BerkeleyLab/Marble-Mini/(threads)

Thread 1 (2018-12-03):

v0.5 schematic review

gkasprow, 2018-12-03:
The v0.5 schematics are here
[AMC_FMC_Carrier-PcbDoc.pdf](https://github.com/gkasprow/Simple_AFC/files/2640740/AMC_FMC_Carrier-PcbDoc.pdf)

ldoolitt, 2018-12-04:
- [ ] Wire main I2C bus (master of U13 TCA9548A) to FPGA user I/O.
- [ ] Move thermometer and power supply I2C to a separate bus, not direclty accessible to FPGA.
- [ ] Wire GPIO0 of XR77129 to FPGA user I/O.
- [ ] Reduce number of non-WR crystals, maybe to zero; The USB crystal may be OK to
  keep, if it stops vibrating when the USB is unplugged.
- [ ] Reference designators should follow IEEE Std 315-1975, in particular:
  Q - transistors
  U - integrated circuits
  Y - crystals
- [ ] Missing self-JTAG. Please wire four user I/O pins to the JTAG lines.

michallgaska, 2018-12-06:
Ok
Next week I will upload schematic with some changes.

ldoolitt, 2019-03-22:
All these points were addressed since the end of January 2019.

Closed 2019-03-22.

Thread 2 (2018-12-04):

White Rabbit oscillators

gkasprow, 2018-12-04:
@michallgaska please follow recent Metlino/Sayma/RFSOC discusions about WR implementation.
We want to use same approach in all our designs. It was  demonstrated that with 2 I2C controlled XO and one clock buffer we can achieve very good phase noise.
[Here ](https://github.com/sinara-hw/sinara/issues/515#issuecomment-416553527)is the discussion and results

ldoolitt, 2018-12-04:
On Tue, Dec 04, 2018 at 10:43:15AM -0800, Greg Kasprowicz wrote:
> We want to use same approach in all our designs. It was  demonstrated that with 2 I2C controlled XO and one clock buffer we cn achieve very good phase noise.
> [Here ](https://github.com/sinara-hw/sinara/issues/515#issuecomment-416553527)is the discussion and results

Has anyone checked the Si549 for Helium sensitvity?
https://hackaday.com/2018/10/31/helium-can-stop-your-iphone-maybe-other-mems-too/
https://www.youtube.com/watch?v=vvzWaVvB908
The problematic SiTime devices are low-frequency low-power devices, which sound more susceptible.
Still, maybe worth checking, especially since helium is not exactly rare in the target environments.

gkasprow, 2018-12-04:
I've read about helium issues with Iphones.
But this affects only MEMS devices.

ldoolitt, 2018-12-04:
On Tue, Dec 04, 2018 at 12:03:12PM -0800, Greg Kasprowicz wrote:
> I've read about helium issues with Iphones.
> But this affects only MEMS devices.

Yes, it's peculiar to MEMS.  Si549 is crystal-based.  Never mind.

ldoolitt, 2019-04-04:
Thanks @gkasprow for bringing this up, and providing the link to WR oscillator work!

I'm going to close this issue, for the following reasons:
1. We have a (presumably) working design based on the previous generation of WR: 25 MHz and 20 MHz VCXOs driven by DACs, and a CDCM61004 multiplying 25 MHz up to 125 MHz MGTREFCLK.
2. The new approaches are still in evaluation, and might end up dropping one device in favor of using internal Xilinx PLLs.
2. It's not clear to me that the new approach is consistent with the trust model assumed on this board.

This topic can be revisited after our first hardware iteration.

Closed 2019-04-04.

Thread 3 (2019-01-10):

Consider table-based entry of pin mapping

ldoolitt, 2019-01-10:

jeinstei, 2019-01-10:
migen/litex style?

ldoolitt, 2019-01-10:
See attached table.tar.gz.

Using a 60-line python program and some _extremely_ simple lists
of application signals, a netlist file (429 entries) is generated.
With some extra work, I assert this netlist can be injected into KiCad.
I'd need to see the KiCad files as you have them now, before I can work
on that step.

The result would IMHO be far more legible and useful going forward than
having page after page of dense signal lists entered into a GUI.
E.g., pins_for_review.png is a screenshot of "paste b*.txt | less -x15"
that captures all of the FPGA user I/O mapping for this board.
Note that the key data file xc7a100tfgg484pkg.txt is directly downloaded
from Xilinx.

[table.tar.gz](https://github.com/gkasprow/Simple_AFC/files/2747238/table.tar.gz)

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

ldoolitt, 2019-01-10:
@jeinstei: I'd take anything based on flat files.  The example I just posted is the simplest I can imagine, but if migen/litex has something similar --- and comprehensible by mortals!  --- I'd take that too.

ldoolitt, 2019-01-10:
@jeinstei: I've messed around with Litex some.  I respect bunnie, and the blog posting that you reference was part of the kick I needed to get started.  My first-hand experience with Litex is what made me add the caveat "comprehensible by mortals".

ldoolitt, 2020-03-05:
I can't see anyone putting in effort to convert this working design to a different design paradigm, so I'll close this issue.
I still think that designs of this scale (and larger) would greatly benefit from using table-based entry of pin mapping. When scripts have access to this information, it's easy and natural to generate cross-reference tables and other derived files like FPGA constraints.

Closed 2020-03-05.

Thread 4 (2019-03-18):

Invalid FMC GA pin connection

kaolpr, 2019-03-18:
According to FMC specification GA[1:0] pins should be connected to either GND or 3V3PAUX and for FMC1 and FMC2 it should be 0b00 and 0b01, respectively.

michallgaska, 2019-03-21:
Fixed!
Thank you.

Closed 2019-03-27.

Thread 5 (2019-03-20):

Add WR-CLK compatibility

kaolpr, 2019-03-20:
At Creotech we're developing a WhiteRabbit CLK module. It is a MCH tongue that allows distribution of WR clock, PPS and timestamp to all AMC modules in a crate without any external cabling (besides fiber to the WR-CLK).

I see that it is possible to make Marble compatible with WR-CLK with relatively low effort:

* TCLKA and TCLKB should be connected to FPGA (SRCC pins),
* at least two MLVDS RX pairs should be connected (ports 17, 18).

Required pins are available in banks 15 and 16.

ldoolitt, 2019-03-21:
> At Creotech we're developing a WhiteRabbit CLK module.
> [It] allows distribution of WR clock [and data].

Sounds great!

> I see that it is possible to make Marble compatible with WR-CLK with relatively low effort:
> Required pins are available in banks 15 and 16.

Maybe.

> * TCLKA and TCLKB should be connected to FPGA (SRCC pins),

TCLKA and TCLKB are diff pairs on AMC backplane.
CC pins in general are a precious commodity in this design.  Let me summarize their allocation per-bank (commit 9dde4030 or c8fd3271):
  b13.  FMC2 LA17 LA18, 2 non-clock; 35-pin bank, half of FMC2, no spare pins
  b14.  FMC1 LA0 LA1 CLK0 CLK1; full
  b15.  MII_RX_CLK, FMC1 LA17 LA18, 1 non-clock; LA33 could be moved
  b16.  VCXO, TMDS, 2 non-clock; 3.3V bank, not valid for LVDS output
  b34.  FMC2 LA0 LA1 CLK0 CLK1; full
  b35.  DDR3 only; full

I can see how to add one LVDS clock to bank 15; there are (more than) two empty pins, and LA33 can be moved.  Will require a remap of at least one MII pin, e.g., MII_RX_DV to H15.

Adding the second LVDS clock is harder; all I can think to do is displace MII_RX_CLK to b16.  That sounds like it will mess up both its timing and voltage threshold compared with all the other MII pins.

When counting b15 pins in the current design, you can consider PHY_RSTn = M17 available after a remap; it's not timing critical.

The other approach is to use pairs on b16, with its 3.3V bank supply.  That prevents use of internal termination, so a 100 Ohm external resistor would be needed per input pair.

> * at least two MLVDS RX pairs should be connected (ports 17, 18).

It sounds like you're asking for two more LVDS input pairs to come from the AMC backplane.  Do these inputs need to be on the same bank as TCLKA and TCLKB?  Are there special considerations for MLVDS on Xilinx 7-series HR pins, distinct from LVDS?  I'm clearly not an xTCA expert; I don't see identifiable "ports 17, 18" on the AMC fingers in our schematic.

Eight total pins are not available on b15 without totally rethinking the MII interface.  If, instead, we consider using b16 and external termination resistors, six pins are immediately available, including two clock pairs.  Freeing up two more pins there will take a little effort, but a couple low-speed signals could be moved to a 2.5V bank.  Worst case, that means adding new level-shift chips.

If the LVDS inputs and the clocks can be on different banks, things might get a bit more flexible.  I have not looked at the layout to see if that adds extra constraints; I know b14 is pretty much surrounded.

ldoolitt, 2019-03-21:
Mikołaj -

Thanks for looking at our board design!

On Wed, Mar 20, 2019 at 04:24:36AM -0700, Mikołaj Sowiński wrote:
> At Creotech we're developing a WhiteRabbit CLK module.
> [It] allows distribution of WR clock [and data].

Sounds great!

> I see that it is possible to make Marble compatible with WR-CLK with relatively low effort:

Maybe.

> * TCLKA and TCLKB should be connected to FPGA (SRCC pins),

TCLKA and TCLKB are diff pairs on AMC backplane.
CC pins in general are a precious commodity in this design.  Let me
summarize their allocation per-bank (commit 9dde4030 or c8fd3271):
  b13.  FMC2 LA17 LA18, 2 non-clock; 35-pin bank, half of FMC2, no spare pins
  b14.  FMC1 LA0 LA1 CLK0 CLK1; full
  b15.  MII_RX_CLK, FMC1 LA17 LA18, 1 non-clock; LA33 could be moved
  b16.  VCXO, TMDS, 2 non-clock; 3.3V bank, not valid for LVDS output
  b34.  FMC2 LA0 LA1 CLK0 CLK1; full
  b35.  DDR3 only; full

I can see how to add one LVDS clock to bank 15; there are (more than)
two empty pins, and LA33 can be moved.  Will require a remap of at least
one MII pin, e.g., MII_RX_DV to H15.

Adding the second LVDS clock is harder; all I can think to do is displace
MII_RX_CLK to b16.  That sounds like it will mess up both its timing and
voltage threshold compared with all the other MII pins.

When counting b15 pins in the current design, you can consider
PHY_RSTn = M17 available after a remap; it's not timing critical.

The other approach is to use pairs on b16, with its 3.3V bank supply.
That prevents use of internal termination, so a 100 Ohm external
resistor would be needed per input pair.

> * at least two MLVDS RX pairs should be connected (ports 17, 18).

It sounds like you're asking for two more LVDS input pairs to come
from the AMC backplane.  Do these inputs need to be on the same bank
as TCLKA and TCLKB?  Are there special considerations for MLVDS on
Xilinx 7-series HR pins, distinct from LVDS?  I'm clearly not an xTCA
expert; I don't see identifiable "ports 17, 18" on the AMC fingers in
our schematic.

Eight total pins are not available on b15 without totally rethinking
the MII interface.  If, instead, we consider using b16 and external
termination resistors, six pins are immediately available, including two
clock pairs.  Freeing up two more pins there will take a little effort,
but a couple low-speed signals could be moved to a 2.5V bank.  Worst
case, that means adding new level-shift chips.

If the LVDS inputs and the clocks can be on different banks, things
might get a bit more flexible.  I have not looked at the layout to see
if that adds extra constraints; I know b14 is pretty much surrounded.

  - Larry

kaolpr, 2019-03-25:
Sorry far such a late answer.

For minimal compatibility with WR-CLK the following is needed:

- TCLKA -> CC diff pair (this line delivers WR clock)
- 2 MLVDS RX diff pairs (one pair for PPS, other for timestamp)

No restrictions on bank placement.

gkasprow, 2019-03-25:
for MLVDS please use dedicated MLVDS transceivers. Standard LVDS would form long stubs. MLVDS transceivers will also enable using 3V3 LVCMOS lines.

ldoolitt, 2019-03-25:
OK, this is starting to sound plausible.  One possible approach:

Move FMC1_LA33 away from a IO_11(SRCC) pair, still within b15.  This will require a cascade of displacements, depends some on routing; one scenario (ignoring routing):
- MII_RX_DV to IO_L14N (pair with MII_RX_CLK)
- FMC1_LA33 to IO_L20,
- Attach TCLKA to IO_11(SRCC).

Add two channels of MLVDS receiver, output to any two convenient FPGA user I/O pins.
- 1 pin free on 2.5V b15, doesn't sound like a good choice
- 6 pins free on 3.3V b16

I need to try a test synthesis to confirm that it's OK to use IO_L14N as data at the same time that IO_L14P is used as a (single-ended) clock.

I'll defer to Michal whether he thinks this can/should be put in for the first article, or if it would add too much time/effort to the schedule.

ldoolitt, 2019-03-25:
@kaolpr:
>  2 MLVDS RX diff pairs (one pair for PPS, other for timestamp)

Couldn't a single lane cover this?  GPS receivers with RS-232 NMEA outputs do this all the time. The start of the timestamp message _is_ the PPS marker.

kaolpr, 2019-03-28:
@ldoolitt Well, it can be done. Let's reduce compatibility requirement to:

- single diff pair for TCLKA,
- single RX MLVDS pair.

gkasprow, 2019-05-02:
@michallgaska I see that you did not add support for WR. This is simple - add MLVDS transceiver and TCLK.

michallgaska, 2019-05-27:
Done.
Can be closed.

ldoolitt, 2019-05-27:
There is no value to controlling U42-2 (#RE), just tie it low.
That way we can all see that FPGA pin C17 (IO_L12N_T1_MRCC_16) is still unused.

Please name the R net (U42-3) to something short and descriptive.
This will turn into the FPGA pin name in the HDL design.

ldoolitt, 2019-05-31:
Confirmed fixed as of commit 0fbafa19

Closed 2019-05-31.

Thread 6 (2019-03-22):

Small schematic problems 2019-03-22

ldoolitt, 2019-03-22:
Found when reviewing commit b527610f

- [x] U34 is incorrectly attached to the FPGA I2C bus; should be APP.

- [x] U39-22 EXP_INT2 is N/C, should go to EXP_INT.

- [x] Add a pushbutton to ARM GPIO (issue first raised in PM 2019-01-31).

- [x] Add two LEDs to I2C port expander (PCA9555) (issue first raised in PM 2019-01-31).

- [x] Improve fusing of FMC 3P3VAUX: possibly use a single fuse for both slots, and definitely provide clear mechanism for software to discover when/if it blows.

michallgaska, 2019-03-27:
Done

Closed 2019-03-27.

Thread 7 (2019-03-22):

Remap refdes to match specs

ldoolitt, 2019-03-22:
The requirements/specs call out specific functionality by refdes:

- U1, the FPGA, Artix-7 in FG484
- U2, a housekeeping microcontroller
- U3, a 512M x 16 DDR3L memory chip
- U4, an RGMII 1000BASE-T PHY
- U5, an RGMII 1000BASE-X PHY
- P1, LPC FMC carrier
- P2, LPC FMC carrier

where we have since merged U4 and U5; the PHY should be called U4.

Please renumber parts in the Kicad design to match.
Calling the primary chip on the board U30 seems suboptimal.
On the layout silkscreen layer, these refdes should be 3 X larger than nominal.

michallgaska, 2019-04-18:
Done

Closed 2019-04-18.

Thread 8 (2019-03-22):

schematics cosmetics

gkasprow, 2019-03-22:
cosmetic issues
- [x]  global FMC labels should be bi-dir not only inputs
- [ ] in all OHWR designs we use certain power port nomenclature like P3V3, N5V0 etc. Is there some reason this was changed? @ldoolitt any preference here
- [x] too many 2k2 I2C pullups. Make sure that when certain port is enabled, the pullup resistance is not lower than 1k. THe switch adds some R to the path and may cause issues. I recommend replacing all pullup R after the switch with 22k
- [x] the Q3 seems to be installed in wrong direction. The inrush current limiter will be bypassed by internal diode.
- [x] please add I2C devices map t othe I2C switch sheet to make sure we don't have address overlaps
- [x] for SFP cages please set right Rd/Td line directions. Now are bidir. RD is output, TD is input.
- [x] add brief name/description of the schematic in the largest frame field.
- [x] for some unknown reason the circuit protecting against glitches on MMC ISP was removed. I suggest adding at least the switch that disables that function when not needed. Otherwize on some PCs the MMC will enter boot mode when USB is plgged and  DTR set to low.

ldoolitt, 2019-03-22:
> in all OHWR designs we use certain power port nomenclature like P3V3, N5V0 etc. Is there some reason this was changed? @ldoolitt any preference here

No preference beyond self-consistency in this design.

> too many 2k2 I2C pullups. Make sure that when certain port is enabled, the pullup resistance is not lower than 1k. The switch adds some R to the path and may cause issues. I recommend replacing all pullup R after the switch with 22k

By "switch" do you mean U5 (TC9548)?  That's a good point; I always looked at that as an active component, but it's actually passive, in a way.  I agree with your 22k solution.  Or maybe 3.3k upstream, 10k downstream?

> please add I2C devices map to the I2C switch sheet to make sure we don't have address overlaps

The I2C subsystem is indeed complicated, and needs better documentation. I was working on that just now.  Address overlaps are not actually a problem, at least after Issue #6 item 1 is fixed.

ldoolitt, 2019-03-23:
> The I2C subsystem is indeed complicated, and needs better documentation.

Here's my first try.  The source eps (xcircuit) file can be supplied on request.
Applies to commit de3cfc8 assuming Issue #6 item 1 is fixed.
Note bus address conflict for U34 and U39, that also needs fixing.
I2C bus signals are named I2C_${BUS}_{SCL,SDA} on the schematic.

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

ldoolitt, 2019-04-04:
@gkasprow please split this list into "bug" (must be fixed before first fab) and "enhancement" (OK to delay work until future revision).  If everything is in the "bug" category, just mark this issue as such.

gkasprow, 2019-04-11:
we can close it now, remaining issues are not relevant anymore.

ldoolitt, 2019-04-15:
Checking commit 38e794c1.  Remaining items in order of importance:

> for SFP cages please set right Rd/Td line directions. Now are bidir. RD is output, TD is input.

SFP1 and SFP2 are fixed, but SFP3 and SFP4 are still wrong.  Please fix.

> add brief name/description of the schematic in the largest frame field.

Not added yet.  Definitely in the "nice to have" category.

> power port nomenclature

Can be left as is for prototyping; we'll see what a larger audience says later.

ldoolitt, 2019-05-02:
Closing this issue.  Thanks @michalgaska for following up on seven of the sub-issues!
If we get complaints about the power supply names, we can update after the first prototypes are made and tested.

Closed 2019-05-02.

Thread 9 (2019-03-26):

Power objects +3V3 and +3V3MP

michallgaska, 2019-03-26:
For some reasons, KiCad can't separate +3V3 and +3V3MP on PCB. It is seen as the same object on PCB. I thought that it was my mistake when I created the power object in the library. But I have tried a few times and I still have the same issue.
Due to this issue, I can't finish two polygons.
I asked Tom Włostowski for a piece of advice in email but I still have been waiting for his answer.

gkasprow, 2019-03-26:
Just change the name of one of them to i.e. P3V3MP Aren't they shorted somewhere on the schematics? Can you look to the netlist if they are not connected somewhere?

gkasprow, 2019-03-26:
@michallgaska U10 and U7 have hidden net which is connected to +3V3MP. It may have already assigned net name to supply pin and this can cause the issue

michallgaska, 2019-03-27:
I found it.
Some devices have a supply pin named VCC and for an unknown reason, KiCad connects these pins to +3V3.
I changed pins name and it solved the issue.

Closed 2019-03-27.

Thread 10 (2019-03-27):

J4 (ethernet connector) alignment pins

yetifrisstlama, 2019-03-27:
The J4 (8P8C, a.k.a. RJ45) footprint has two mechanical alignment pins (NPTH) that erroneously have pad numbers 21 and 22, duplicating the _real_ 21 and 22 pads that are used for the shield.
They also shouldn't have a Net associated to them. This makes up for 2 of the remaining `unrouted connections`.

For some reason the Net and pad number disappears when you check `Show pad in outline mode` in the Pad properties.

Tested on Kicad 5.1.0-62-ge5de787f8 and Kicad 5.1.0-rc1-109-ge71b21596.
Maybe it's really a footprint problem?

michallgaska, 2019-04-02:
Fixed

Closed 2019-04-02.

Thread 13 (2019-04-08):

DC drop simulations

michallgaska, 2019-04-08:
I made a preliminary simulation of voltage drop on power lines.
There are no huge voltage drops so it looks very promising.
Polygons have slightly too big clearance to vias in comparison to the original project.
Results would be a little better if I had Hyperlynx files with proper clearance.

**1V @ 6A:**
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

**1V MGTAVCC @ 0.2A**
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

**1.2V MGTAVTT @ 0.1A**
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

**1.35V @ 0.55A**
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

**1.8V VCCAUX @ 0.4A**
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

**2.5V @ 1.1A**
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

**3.3MP @ 0.15A**
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

**3.3V @ 2.85A**
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

gkasprow, 2019-04-08:
@michalgaska did you update the stackup in Hyperlynx? The tool places default stackup since the Kicad does not have the stackup editor.

michalgaska, 2020-09-12:
Simulations were made with proper stackup.
The issue can be closed.

Closed 2020-09-12.

Thread 14 (2019-04-15):

3P3VAUX monitor

ldoolitt, 2019-04-15:
Please change R259 and R261 to about 1kOhm.
I don't think we want the MMC to be able to (attempt to) power 3P3VAUX from an I/O pin after a fuse is blown.

michallgaska, 2019-04-15:
Done

Thread 15 (2019-04-15):

ERC errors

ldoolitt, 2019-04-15:
As of commit 38e794c1, schematic ERC (Electrical Rules Check?) reports 10 Errors and 423 Warnings.  I'm not qualified to comment on whether any of these represent actual netlist errors that need to be fixed before prototyping.  I do think the design should pass ERC before it can be considered done and releasable.

ldoolitt, 2019-04-26:
As of commit fdb63ea5, schematic ERC reports 11 Errors and 53 Warnings.  Sounds like an improvement to me, thanks @michalgaska!  It would be nice to get the Error count down to zero, if that's possible.

yetifrisstlama, 2019-04-27:
some thoughts on the schematic ERC errors I was seeing:

  * `Label not connected anywhere else in the schematic` I've seen this on many busses. Looks like a Kicad bug / weirdness to me, as the highlight net tool shows the connection is there
  * `Pin connected to other pins, but not driven by any pin`  ... needs a PWR_FLAG symbol placed on the net to tell Kicad it is driven by a power source
  * `Pin not connected (use a "no connection" flag to suppress this error)` ... self explaining
  * `More than one name given to this bus or net` ... i suspect this is due to a hidden pin of the same name. Not sure how to solve this

ldoolitt, 2020-05-05:
Fixed (to the maximum extent possible) in commit 6cafe828 (branch fab2).
Still one unavoidable ERC error due to the ERC process not understanding DNF attribute of Y1.

Closed 2020-05-05.

Thread 16 (2019-04-15):

Paste on gold fingers

ldoolitt, 2019-04-15:
As of commit 6ad5d6c2, there is both front and back paste placed on the gold fingers of P1 (AMC).  Layer IDs are F.Paste and B.Paste.  This needs to be taken off.  Probably a footprint problem.

gkasprow, 2019-04-16:
the same probably applies to fiducials and test points.

michallgaska, 2019-04-18:
Done

Closed 2019-04-18.

Thread 17 (2019-04-15):

Too much silkscreen clutter by gold fingers

ldoolitt, 2019-04-15:
As of commit 6ad5d6c2,
Cute rendition of the EMI fingers of the SFP cage will clutter the area also used by P1 (AMC) gold fingers.  It would be better to take away that ink from F.SilkS.

michallgaska, 2019-04-18:
Done

Closed 2019-04-18.

Thread 18 (2019-04-15):

Integrate KiCad workflow better with git

ldoolitt, 2019-04-15:
At the minimum, I think the following files should be removed and listed in .gitignore:
* AMC_FMC_Carrier-PcbDoc.kicad_pcb-bak
* fp-info-cache
* AMC_FMC_Carrier-PcbDoc-rescue.lib

but please check this with git and/or KiCad experts, and test that the resulting repo is usable.

There's a longer set of instructions for using git and KiCad together at [plotkicadsch](https://jnavila.github.io/plotkicadsch/).  There are clearly some good lessons in there, but in total it's kind of intricate. We don't have to do everything all at once.

ldoolitt, 2019-05-16:
@michalgaska and I have both made commits addressing this issue.

Other people should check that the result is usable, and maybe leave a comment here.

yetifrisstlama, 2019-06-03:
Looks good to me, can be closed.

ldoolitt, 2019-06-04:
Closing now.  Please re-open if you (anyone) find specific problems.

Closed 2019-06-04.

Thread 19 (2019-04-16):

Logos

ldoolitt, 2019-04-16:
Add as many as you can think of: Creotech, Politechnika Warszawska, LBNL, KiCad, OHWR.
Also designers' names: Michal, Larry, and as many others as want to be associated with the result.
If you can find room, getting something in copper (not just silkscreen) is a "nice to have".
Directly before release, add a revsion date and git commit id.

ldoolitt, 2019-04-29:
The logos are on and look great!  Thanks @michalgaska!
Leaving this issue open as a reminder to
> Directly before release, add a revision date and git commit id.

csp, 2019-04-29:
I see that the front has two areas with logos, one of which will be covered when a mezzanine is connected. For the others, can we replace those with at least LBNL and Creotech logos?

gkasprow, 2019-05-02:
I'm not sure if we can place CE logo here. We did not certify this board.
The board is just a component so we would rather certify the whole box with this board and place the CE logo there.

gkasprow, 2019-05-02:
We usually do not place individuals names on the boards. It's a collective effort so just institution name is sufficient. Names are placed on schematics and PCB drawing tables where indicate who designed and who verified each part.

ldoolitt, 2019-05-02:
I agree a board like this is a big team effort - and putting more names on is fine.
But if you're uncomfortable with people's names on the board, take them off.
We at LBNL typically do put the designers' names on.  I think of it like an artist signing a painting, giving credit and recognition to someone who put in the effort.

gkasprow, 2019-05-02:
well, it's not really a piece of art :) It's good engineering. I had a colleague who treated PCBs like a piece of art but they usually did not work well because for him good look was more important than Signal Integrity :)
On commercially available electronics you won't find authors names.
A long time ago we had such discussion at OHWR and the conclusion was that we do not place a list of all contributors, but a link to the repo where this information is provided.

ldoolitt, 2019-05-02:
> On commercially available electronics you won't find authors names.

One exception is on chip masks, where you find all kinds of crazy stuff.  :-)
I can accept the conclusion, no names on this board.

ldoolitt, 2019-05-10:
Closing because it's mostly done, and the un-done stuff is not related to the issue title.
Will open a fresh issue for revision date and git id.

csp, 2019-05-30:
Re-opening this issue. This is my original request regarding logos: I see that the front has two areas with logos, one of which will be covered when a mezzanine is connected. For the others, can we replace those with at least LBNL and Creotech logos?

ldoolitt, 2019-06-03:
Confirmed good in commit 0293096. Thanks @michalgaska!

Closed 2019-06-03.

Thread 20 (2019-04-22):

Please provide FPGA pin mapping file

ldoolitt, 2019-04-22:
Either simple flat-text, or .xdc for Vivado.
Ideally this will machine-generated from the KiCad schematic, with instructions for doing so in the README (hope for "make marble.xdc").
If some post-processing is needed to get this into a useful form, we at LBNL can help.
It's definitely not acceptable to key it all in by hand, A really ugly but possible short-term workaround is to cut-and-paste things bank-by-bank from the PDF.

gkasprow, 2019-04-23:
I used to extract such info from raw netlist. It's just a metter of copying
piece of netlist that contains nets around FPGA designator. One remark -
make sure all FPGA nets are named. Sheet entries do not alway name nets so
I always add net names close to the FPGA pins

ldoolitt, 2019-04-23:
@gkasprow wrote: I used to extract such info from raw netlist.

Sure, there's always a way.  The more automated and guaranteed-correct the better.
The path would be more clear if anyone had followed through on #3.

gkasprow, 2019-05-02:
Orcad PCB netlist output seems to be human-readable form. It's the only format among supported by Kicad where nets are grouped by symbols.
The netlist looks almost ready to use :
```

(  AA3 FMC2_LA_9_N )
  (  AA4 FMC2_LA_1_N )
  (  AA5 FMC2_LA_15_P )
  (  AA6 FMC2_LA_11_N )
  (  AA7 +2V5 )
  (  AA8 ? )
  (  AA9 FMC2_LA_27_P )
  ( AA10 FMC2_LA_20_P )
  ( AA11 FMC2_LA_20_N )
  ( AA12 GND )
  ( AA13 FMC2_LA_31_P )
  ( AA14 FMC2_LA_21_N )
  ( AA15 FMC2_LA_32_P )
  ( AA16 FMC2_LA_26_N )
  ( AA17 +2V5 )
  ( AA18 FMC1_LA_6_P )
  ( AA19 FMC1_LA_10_P )
  ( AA20 FMC1_LA_7_P )
  ( AA21 FMC1_LA_7_N )
```

after one minute of play with text file I got ready to use pin mapping
[FPGA_pin_mapping.txt](https://github.com/gkasprow/Simple_AFC/files/3137409/FPGA_pin_mapping.txt)

ldoolitt, 2019-05-10:
This is helpful, and I'll add a separate issue for myself to synthesize a test bitfile.
I will leave this issue open until there's a fully automatic flow from KiCad to Xilinx .xcd file.

ldoolitt, 2020-03-05:
This work was completed August 2019 with commit a1ed1ff.
Instructions for how to generate Marble.xdc are in the README.
Tested on hardware, works.
Thanks, @michalgaska!

Closed 2020-03-05.

Thread 21 (2019-04-25):

Improve support for FMC JTAG

ldoolitt, 2019-04-25:
If I read the schematics correctly, the only access provided to the FMC JTAG pins is via J14 Conn_ARM_JTAG_SWD_10.  The JTAG chain (slaves) accessible from that connector starts with U2 LPC1776, and will have FMC1 and FMC2 switched in when the corresponding PRSNT_M2C signals are asserted.

My understanding is that a few FMC mezzanine cards (including CUTE-WR) use their JTAG lines for maintenance. While these boards could be tested with the current design of Marble, by attaching a JTAG pod to J14, there's no sane way to support deployment of such cards.

Please add the capability to drive these FMC JTAG pins by GPIO pins of U2 LP1776 (MMC), which can bit-bang the JTAG protocol.  The MMC is presumed to be attached (or attachable, however indirectly) to some source of programming instructions for the FMC mezzanines. You can keep J14's capability to master FMC JTAG as a resistor-strappable option.

This concern was prompted by studying ERC output, in combination with emails from last July.
The current design leaves FMC TRST pins floating; shouldn't they be tied down somehow?

michallgaska, 2019-04-26:
I connected both FMC JTAG to MMC.
Driving FMC JTAG by MMC should be a default mounting option?

gkasprow, 2019-04-26:
I'm not sure if I follow you. The idea behind FMC JTAG was identical as we do in Sayma AMC. Some FMC modules, like CUTE-WR nodes, have FPGA on FMC. The FPGA JTAG is accessible via FMC JTAG.
So, once the FMC is inserted, the FMC is included in the carrier JTAG chain.
There is a risk that FMC is not designed according to specification and the chain is not closed by default (TDO not shorted with TDI). In such a case the MMC should be able to overwrite the PRSNT pin and close the FMC JTAG chain by the analog switch.
Xilinx devkits have JTAG implemented in the same manner.
MMC can use bit-bang JTAG, there is even Xilinx virtual cable protocol, but it makes sense when MMC has Ethernet access. I don't see many use cases for MMC- FMC JTAG connectivity.

ldoolitt, 2019-04-26:
> I'm not sure if I follow you.

I agree this is confusing, and that's bad.  For a start, I request more notes on the schematic about which zero-ohm resistors are placed to enable which features.

> The idea behind FMC JTAG was identical as we do in Sayma AMC.

OK.  I haven't looked at Sayma design in months, I guess i should refresh myself.
Can a remote in-the-field Sayma carrier, not attached to a bench-top JTAG pod, act as a JTAG bus master for the FMC JTAG chain?

> Some FMC modules, like CUTE-WR nodes, have FPGA on FMC.

Yes.  Clarifying, some FMC mezzanine cards with an on-board FPGA attach that chip's dedicated JTAG slave port to the FMC connector's dedicated JTAG pins.

> There is a risk that FMC is not designed according to specification and the chain is not closed by default (TDO not shorted with TDI). In such a case the MMC should be able to overwrite the PRSNT pin and close the FMC JTAG chain by the analog switch.

Right, that's a useful feature.  I guess it is part of the Sayma design.  Is it part of our Marble design now?

> Xilinx devkits have JTAG implemented in the same manner.

Can you be a bit more specific?  Which devkit? Are you talking about the analog switch with an override feature? And is this the JTAG chain that is only accessible to a bench-top JTAG pod?

> MMC can use bit-bang JTAG, there is even Xilinx virtual cable protocol, but it makes sense when MMC has Ethernet access.

The MMC is always assumed to have a data link to the outside world.  In xTCA that's over IPMB.  In the NAD world I will set up a bridge from Ethernet through the FPGA via SPI.

> I don't see many use cases for MMC- FMC JTAG connectivity.

OK.  But I don't want to force people to add extra hardware in order to access the FMC JTAG chain.  That hardware may be easy and convenient in a lab setting, and that use case should be supported, but Marble is intended to support deployment of tens or hundreds of units out in the field where physical access is a problem.

> Driving FMC JTAG by MMC should be a default mounting option?

Since we don't have software written, and it's a specialized use case (no immediate demand to deploy Marble+CUTE-WR in the field), I vote to have the standard/initial build jumpered to give J14 access to FMC JTAG.

gkasprow, 2019-05-02:
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

In Sayma we do not have such a feature because there are other components in the ARTIQ environment that are updated via USB JTAG.

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

not yet. One resistor and connection to the MMC does the job.

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

for example KC705. In our case, it is implemented in the same way.
Moreover, I would add 0R resistors that disable MMC JTAG.
MMC should have its individual SWD connector mounted by default. Using the same JTAG connector for both FPGA and MMC would be a real nightmare during development. I'm afraid that CPU debugger may have issues with talking with CPU with other JTAG devices in the chain. Another problem would be with SWD mode that won't work in such setup.
So I think dedicated SWD/JTAG connector is a must. Just copy working solution from Sayma and do not mount 0R resistors that connect it with rest of JTAG chain.

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

OK, this would work but I doubt if somebody finally implements it, having working self-programming solution :) Or are you talking about a link for diagnostics, sensor readout etc ?

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

OK, It's better to add such support then.

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

agree

michalgaska, 2020-09-15:
Can be closed

Closed 2020-09-15.

Thread 22 (2019-04-27):

U35 (XRP7724) pin 23 and 34 are not connected

yetifrisstlama, 2019-04-27:
quote from the datasheet:

Gate Drive supply. Two independent gate drive supply pins where pin 34 supplies drivers 1 and 2 and pin 23 supplies drivers 3 & 5. One of the two pins must be connected to the LDO5 pin to enable two power rails initially. It is recommended that the other VCCD pin be connected to the output of a 5V switching rail(for improved efficiency or for driving larger external FETs), if available, otherwise this pin may also be connected to the LDO5 pin. A bypass capacitor (>1uF) to PAD is recommended for each VCCD pin with the pin(s) connected to LDO5 with shortest possible length of etch.

michallgaska, 2019-04-29:
Done

Thread 23 (2019-04-27):

U36, U37 (NCP186AMX180TAG): IN and OUTPUT pins are swapped

yetifrisstlama, 2019-04-27:
Pin numbers on the schematic symbol do not match the datasheet (XDFN8 package)

https://www.mouser.com/datasheet/2/308/NCP186-D-968152.pdf

Needs to be fixed on the PCB as well

michallgaska, 2019-04-29:
Great point!
Fixed

Closed 2019-04-29.

Thread 24 (2019-04-27):

U27 (MAX6639) pin 12 (DXP2) not connected

yetifrisstlama, 2019-04-27:
from datasheet:
Do not leave unconnected; connect to DXN if no remote diode is used

https://datasheets.maximintegrated.com/en/ds/MAX6639-MAX6639F.pdf

michallgaska, 2019-04-29:
Fixed

Closed 2019-04-29.

Thread 25 (2019-04-27):

FMC_2.sch: pin c34 is hard-wired to FMC2_3P3VAUX

yetifrisstlama, 2019-04-27:
It should be connected to net GA0_2 instead. The connection to FMC2_3P3VAUX is made on the top level.

michallgaska, 2019-04-29:
fixed

Closed 2019-04-29.

Thread 26 (2019-04-29):

SW2 placement

ldoolitt, 2019-04-29:
SW2 looks ideally placed for AMC slot builds, but that's not very useful for NAD builds.
Please add a header in parallel, so a cable can be used to move this functionality to a chassis panel.  NAD builds would mark SW2 as DNP.

My ideal would be a 4x2 100-mil header with connections to two push-buttons (PB1 and SW2) and two LEDs (maybe with separate ballast resistors but otherwise parallel with LD11 and LD13?).  For height reasons this would have to be placed "to the right of" the FMC connector. Compatible switch/LED assemblies are cheap and widely available as part of ATX PC cases or case-substitutes.

gkasprow, 2019-05-02:
The idea behind SW2 was board reinitialization in the crate without a need for power cycling.
The use case for a stand-alone application would probably be different because power cycling is much easier than in MTCA.

ldoolitt, 2019-05-02:
Of course everything is software-defined, but my biggest interest in SW2 for a NAD is a "reset IP address to factory default" function.

gkasprow, 2019-05-02:
Good idea. We can also place tiny SMT switch available via panel hole with some needle.

ldoolitt, 2019-05-02:
> We can also place tiny SMT switch available via panel hole with some needle.

Fine with me, if you can make it work.  The panel side for a NAD is squeezed in by the Ethernet and SFP, and power entry, where there isn't a lot of room left.

gkasprow, 2019-05-02:
I use tiny switch that fits below Ethernet connector.
KSS241G LFS

On Thu, 2 May 2019 at 17:24, Larry Doolittle <notifications@github.com>
wrote:

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

michallgaska, 2019-05-09:
I added a tiny switch.
@ldoolitt do you still need a header with connections to two LEDs?

ldoolitt, 2019-05-09:
> I added a tiny switch.

I see it, SW3.  It looks too close to the board edge.  Its drawing shows the button extending 0.8 mm from the pad; the layout in commit 7c5c3c37 only leaves 0.5 mm.

> do you still need a header with connections to two LEDs?

No, this is fine for now.

ldoolitt, 2019-05-10:
Re-opened as a reminder to shift the new SW3 (in parallel with SW2) left by at least 0.5 mm.

michallgaska, 2019-05-13:
Done

Closed 2019-05-13.

Thread 27 (2019-04-29):

Review and organize DNP status for parts

ldoolitt, 2019-04-29:
We keep talking about parts being loaded for only one of the two styles of board assembly, AMC and NAD.  Since the first prototypes are headed for NAD-style testing at LBNL, AMC-only parts should be marked DNP (do not populate) for now.

We do need some organization and/or KiCad mechanism to clearly document what parts go with which build, such that a BOM and assembly file can be constructed cleanly for both types.  That step is _not_ a prerequisite for the first prototype (NAD) assembly.

gkasprow, 2019-05-02:
For the CERN project the Altium variants are not used for a number of reasons.
Each component has a field called "Assembled" and value "Yes" or "No". And this field is then generated with BOM, but NOT with p&p files!
This cames probably from an early version of Altium where assembly variants were not supported.
I remember the times where PCAD was used at CERN, then Altium purchased PCAD and discontinued it. All clients switched to Altium then. Maybe it is reminiscent of those times.
Good assembly variant support like Altium has would be a great tool.
I tried to use Mentor Xpedition assembly variants but it was a real nightmare. The Altium approach where assembly variant information is preserved in a dedicated file is a good idea because it does not affect schematics nor PCB, only BOM and p&p files.

michallgaska, 2019-05-09:
I found a very nice tool to generate a BOM file. It supports PCB variants.
https://github.com/SchrodingersGat/KiBoM

ldoolitt, 2019-05-09:
> I found a very nice tool to generate a BOM file. It supports PCB variants. https://github.com/SchrodingersGat/KiBoM

Yes, that looks like it has the features we want.

Do you plan to set up for this (adding all the Config (fit_field) entries) before the prototype fab run?

michallgaska, 2019-05-10:
I made the first attempt to set up a variant for the standalone version using KiBoM.
I have created _standalone_ variant of the board.
which clock is the default FPGA MGT clock? WR?

ldoolitt, 2019-05-28:
First prototype build will be standalone (NAD) style, using the WR clock.
Referencing commit d4c25c16, I think dnf attributes should be added to:
- [ ] S1
- [ ] SW2
- [ ] 16 capacitors routing MGT lanes to AMC fingers
- [ ] 4 capacitors routing MGT_CLK_1 to other than FPGA_REF_CLK0
- [ ] 2 capacitors routing MGT_CLK_0 to other than ??
I don't see a particularly useful source for MGT_CLK_0.  It might be nice to have an option for FMC2_CLK0_M2C, but that would conflict with the existing route of that clock to bank 34 MRCC pins.

That's all I see for now, but I'll keep looking.
@gkasprow  should also review this list.

Some of these, like the MGT lane routing, look already handled by the "config" attribute on the parts, which will drive KiBoM.  Other than clicking on the attribute editor for every part, do you know of a way to review all the "config" attribute values?

It would also be nice if there were documenation (in README.md?) for what the board's KiBoM options are, and how to generate the BoM file with that tool.  Maybe it's there, and I just don't see it.

ldoolitt, 2020-03-05:
The design as-built uses KiBoM as suggested, so I'll close this issue.

There is a minor residual problem that the build variant and resulting parts (or DNF) selection is not visible on schematics.  This is a generalization of #47, so that's where further discussion belongs.

Closed 2020-03-05.

Thread 28 (2019-05-03):

DDR3 schematic tweaks

ldoolitt, 2019-05-03:
A friend of mine looked through the schematic and gave me comments.
I hope this issue captures those ideas relating to the DDR3 schematic.

In general, deviations in this part of the schematic from Arty should be looked on with suspicion.
If we have a good reason to deviate, that should be noted and explained on the schematic.
I'm taking as reference Arty rev E.1, 2018-01-09
https://reference.digilentinc.com/_media/reference/programmable-logic/arty-a7/arty_a7_sch.pdf
7ab6ec142107efa10dd91654ad1f462544ba190af551292ac7d49c4649af9870  arty_a7_sch.pdf

Particulars:
- [ ] Change clock termination to 80 Ohms differential
- [ ] Change address termination resistors to 40 Ohms
(see https://www.xilinx.com/support/answers/42024.html, which talks about using 40 Ohms for the trace impedance, also)
- [ ] ODT pin termination should be 40 Ohms to V_tt
- [ ] Add more decoupling capacitors on +1V35, currently 8 where Arty has 19

gkasprow, 2019-05-03:
fully agree.
- [ ] there should be more capacitors on VTT. At least 5.
- [ ] 40Ohms are hard to get. use 39R9 instead.
- [ ] make sure that address lines impedance is 40Ohms.
- [ ] the clock signal is still referenced to VTT so I wouldn't use single 80R differential termination but 2x40R as it is now.

ldoolitt, 2019-05-03:
> 40Ohms are hard to get. use 39R9 instead.

OK, that's definitely close enough to 40. Arty uses 40R2, I rounded.

> the clock signal is still referenced to VTT so I wouldn't use single 80R differential termination

I see several clock signal termination topologies suggested by experts.  DIMMs use split termination resistors, center tap AC coupled to V_DD.  Weird.
https://www.micron.com/-/media/client/global/documents/products/data%20sheet/modules/sodimm/jsf4c128x64hz.pdf
Of course, many experts also say to make sure to run signal integrity simulations as the final guide.

ldoolitt, 2019-05-03:
>>  40Ohms are hard to get. use 39R9 instead.

> OK, that's definitely close enough to 40. Arty uses 40R2, I rounded.

Searching Digi-Key for 1% 0402 resistors near 40 Ohms, the top 10 in quantity-available are all either 39R0, 39R2, or 40R2. I recommend putting 40R2 on our schematic.  There are just over 2 million Yageo RC0402FR-0740R2L on-the-shelf.

ldoolitt, 2019-05-09:
> [WP484 v1.0] uggests using 50R impedance and termination.

That document dates from September 2016.  AR# 42024 I gave above with the 40R suggestion is dated June 2014.  The Arty schematic that uses 40R2 is dated January 2018.

> we applied such DDR design in Kasli and it works perfectly.

At what speed?  The Arty also works perfectly.  A single resistor is easy to change, but a generic change from 50R to 40R means changing 25 such resistors, which would be tedious.

michallgaska, 2019-05-15:
I added more decoupling capacitors to the DDR3 power supply and VTT.
I changed the termination resistors to 40R2.
I didn't change traces impedance.
According to the simulations, DDR3 will work.

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

Closed 2019-05-15.

Thread 29 (2019-05-03):

[CRITICAL] Exar current sense connection

gkasprow, 2019-05-03:
Existing connection of current sense of Exar will cause immediate damage to the controller.
I placed R190, R191, R192, R194 on purpose to make sure GL_RTNx pins won't be connected to the nearest GND potential.
These resistors must be placed very close to the output transistors sources to measure real drop on RDSon. The existing connection will cause the wrong measurement of the MOSFET current and failure of the controller regulation loop. The MOSFET source pad must be connected to the GND by vias and not share the plane with any other component, only the 0R resistor.
Please look at how it was done on Sayma. Highlighted is GND sense connection. Please refer to Exar layout manual.
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

michallgaska, 2019-05-06:
Fixed

Closed 2019-05-06.

Thread 30 (2019-05-03):

power sequencing

gkasprow, 2019-05-03:
The MGTAVTT is derived from +3V3 and VCCAUX is derived from +2V5.
Does it take into account FPGA power sequencing recommendations?
Is a recommended sequence possible with such wiring?

michallgaska, 2019-05-06:
According to the datasheet:
https://www.xilinx.com/support/documentation/data_sheets/ds181_Artix_7_Data_Sheet.pdf

>  The recommended power-on sequence is VCCINT, VCCBRAM, VCCAUX, and VCCO to achieve minimum current draw and ensure that the I/Os are 3-stated at power-on.

> If VCCAUX and VCCO have the same recommended voltage levels then both can be powered by the same supply and ramped simultaneously.

Now the power sequence is:
1. 1V0 (VCCINT, VCCBRAM, MGTAVCC)
2. 2V5 (VCCO) -> 1V8 (VCCAUX)
3. 3V3 (VCCO) -> 1V2 (MGTAVTT)
4. 1.35 (VCCO)

> The recommended power-on sequence to achieve minimum current draw for the GTP transceivers is VCCINT, VMGTAVCC, VMGTAVTT or VMGTAVCC, VCCINT, VMGTAVTT.

Thus MGTAVTT is on after VCCINT and MGTAVCC.
There is no information that MGTAVTT can't be ramped with VCCO.
On Kasli board there is Artix 7 and MGTAVTT is derived from VCCO (2V5) and it doesn't cause any issue.

Closed 2019-05-09.

Thread 31 (2019-05-03):

SI issues

gkasprow, 2019-05-03:
the AMC connector signals have missing reference plane under some trace sectors
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

Moreover, the opposite AMC connectors contacts don't have any GND reference below.
The pad width is 0.47mm so to maintain 50R impedance, the reference should be placed 0.25..0.3mm below. Now there is no reference at all. Look how it is done on Sayma. On second layer there are cutouts in the plane. On L3 there is no copper
P2:
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
L3:
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

gkasprow, 2019-05-03:
The same applies to SFP pads. Look how it is done on Sayma
P2:
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

On L3 there cannot be any traces nor polygons below. To make sure I place there polygon cutout.
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

michallgaska, 2019-05-06:
Fixed

Closed 2019-05-06.

Thread 33 (2019-05-10):

Test synthesis

ldoolitt, 2019-05-10:
Given the pin mapping file posted in #20 , take an exsiting useful design and synthesize for this board. Must happen before board goes out for fab, to make sure we haven't misunderstood some stupid Xilinx physical constraint.

ldoolitt, 2019-05-31:
Vamsi confirms RGMII and DDR3 are ok for synthesis.
FMC looks good, but not fully confirmed.  Still working on it.

ldoolitt, 2019-05-31:
@michalgaska please check DDR3 pin-compatibility with Xilinx MIG.

ldoolitt, 2020-03-05:
Ethernet, MMC, I2C, and Pmod connectivity all work as expected on hardware. FMC connectivity passes tests using the OHWR [FMC Carrier Tester board](https://ohwr.org/project/fmc-conn-tester/wikis/home).  I think the only thing left to do before closing this bug is DDR3 checkout / confirmation. @michalgaska, any progress on Xilinx MIG?

michalgaska, 2020-03-06:
Unfortunately, I don't have any progress with MIG.

ldoolitt, 2020-09-12:
Closing, since the first-prototype run (commit a1ed1ff17) has proven itself with usable with designs from:

* [Bedrock](https://github.com/BerkeleyLab/Bedrock) (no DDR3 support)
* [LiteDRAM](https://github.com/enjoy-digital/litedram) (using all 1024 GiB DDR3)
* conventional Xilinx uBlaze/MIG (but only with 512 GiB DDR3 visible)

Closed 2020-09-12.

Thread 34 (2019-05-10):

Include revision date and git commit ID on board

ldoolitt, 2019-05-10:
Place-holder issue to remind @michallgaska to put board design revision info (including git commit id) on something (silk, copper) physically visible on the hardware.  Necessarily done at the last minute, after all other changes.

Ideally this step will be automated, but that's definitely not essential for the first prototype.

csp, 2019-05-30:
Can we include a version number corresponding to a tag? The first revision should have v1.0 printed on the board, this makes it easy to identify them when we go into production of the next versions and end up with boards of different production runs

michalgaska, 2019-11-13:
I think it is done.

jersey99, 2020-02-04:
Closing this.

Closed 2020-02-04.

Thread 35 (2019-05-13):

FPGA boot and MMC

ldoolitt, 2019-05-13:
Quoting the Marble board's spec:
> As important as the microcontroller is to the long-term serviceability of
> the board, it should not be needed to exercise the core functions of powering
> the board, or loading and running a bitfile.

Side note to @csp: can we convert the spec to Markdown and check it in to github?

The default (reset) state of most LPC1776 I/O pins is as inputs, with a weak (less than 70 microamp) pull-up.

My review of the design, while reading UG470 (7 Series FPGAs Configuration) shows that some changes are needed before this requirement is satisfied. In particular the board should boot from on-board SPI flash (Master SPI Configuration Mode, M[2:0] = 001), without help from the MMC.
- [x] Pull-up ≤ 1 kOhm on M[0] to +2V5
- [x] Pull-down ≤ 1 kOhm on M[1] and M[2]
- [x] Pull-up ≤ 4.7 kOhm on INIT_B (not pull-down)

Right now M[2:0] are attached to the MMC.  I don't have a use case for this. The only thing I could possibly think the MMC would want to do is disable SPI boot, by pulling M[2] high.
Fortunately the LPC I/O are pretty strong, since the required default pull-down is less than 1 kOhm.  Unfortunately the LPC I/O voltage is +3.3V, which doesn't match the +2.5V of these pins. Maybe M[2] gets 330 Ohm series to the LPC1776, with a 1.0 kOhm pull-down?

The pull-up on PROGRAM_B, R160 is currently set to 1 kOhm. The Xilinx requirement is ≤ 4.7 kOhm.  All the examples in UG470 show 4.7 kOhm.
- [x] Use larger value for R160, maybe 2.2 kOhm?

UG470 documentation for the DONE pin says:
"Note: DONE has an internal pull-up resistor of approximately 10 kΩ. There is no setup/hold requirement for the DONE register. These changes, along with the DonePipe register software default, eliminate the need for the DriveDONE driver-option. External 330Ω resistor
circuits are not required but can be used as they have been in previous generations."
- [x] Suggest marking R162 as DNF

ldoolitt, 2019-05-16:
Confirmed all fixed as of commit ceb0f520.  Thanks, @michalgaska !

Closed 2019-05-16.

Thread 36 (2019-05-16):

Fix level of 25 MHz clock supplied to U2 (PHY) and U4 (MMC)

ldoolitt, 2019-05-16:
CLK_25MHZ from CDCM61004R is 3.3V LVCMOS. This is too large a swing for both the MMC XTAL1 pin U2-L2. and the PHY XTAL_IN pin U4-34

- [x] Convert C92 to 150 pF in this configuration
- [x] Remove R132
- [x] Replace R63 with capacitive divider (100 pF / 100 pF) between CLK_25MHZ and U4-34,
suggest placement close to U4

3.3V * 100 / (100+150) = 1.32 V, between 0.28 V and 1.4 V, OK for U2-L2

3.3V * 100 / (100+100) = 1.65 V, less than 1.8 V, OK for U4-34

This assumes there's nothing surprising contained in Marvell's non-public MV-S301630-00, "Oscillator level shifting".

ldoolitt, 2019-05-20:
Fixed with commit 23189cfb.  Looks good, thanks @michalgaska!

Closed 2019-05-20.

Thread 37 (2019-05-29):

Symbol library management

yetifrisstlama, 2019-05-29:
Larry found some issues related to ERC in some of the schematic symbols. However as long as we load the symbols from the `-cache.lib` file, we cannot edit them.

I suggest to rename `AMC_FMC_Carrier-PcbDoc-cache.lib` to `AMC_FMC_Carrier-PcbDoc.lib` and include it in Kicad as a project specific symbol library.

I found [this guide](https://hackaday.com/2017/05/18/kicad-best-practises-library-management/) explaining the details.

Ideally we should not have to depend on `-cache.lib` or `-rescue.lib`

ldoolitt, 2019-06-13:
This specific problem is the tip of a larger iceberg.  We really need the library entries for the specific parts this design uses, in order to maintain or upgrade this design going forward.  This includes getting access to the 3D model part of these items, so as to be able to produce a 3D rendering of the assembled board as shown on this project's README.  This also practically prevents us from pushing changes to github, since every time we load the design, Kicad redirects library links to the local cache.

As I understand it, most or all of these parts come from a CERN library, and there are negotiations taking place for how and when to copy. license, and publish this subset.

This bug sounds trivial, and definitely shouldn't slow down our production of prototypes, but is a critical bug moving forward!  Until it is solved, the OHWR nature of this design is hollow.

ldoolitt, 2020-02-02:
Some WIP on this issue is now in the local-lib branch.
Tomasz is also looking into it.

ldoolitt, 2020-05-05:
More progress in the fab2 branch, based on great work by @yetifrisstlama .
Specifically as of commit 6cafe828 the ERC fixes are in the self-contained libraries.
3D models are **not** currently available.
I'd like to verify that features can be added in this mode before closing this issue.

ldoolitt, 2020-05-27:
Still missing the 3D models, but the fab2 branch feels maintainable, with coordinated commits from three people.  Closing this issue.

Closed 2020-05-27.

Thread 38 (2019-05-31):

acid pockets

gkasprow, 2019-05-31:
make sure that vias are either open on both sides or tented on both sides.
You cannot make via tented on one side because it creates a pocket.

michalgaska, 2019-06-03:
I can't change vias tenting in KiCad.
We have to live with tented vias.

gkasprow, 2019-06-03:
Maybe it's good time to request such feature ?

yetifrisstlama, 2019-06-04:
There is a `Do not tent vias` option when you generate the gerbers (File --> Plot...)

michalgaska, 2019-06-04:
I know that option but we don't want to tent all vias.

gkasprow, 2019-06-04:
just place a polygon on the solder mask which will expose the vias.

michalgaska, 2019-11-13:
Improvement for the next version.

michalgaska, 2020-09-12:
The issue can be closed.

Closed 2020-09-12.

Thread 39 (2019-05-31):

Rename MII signal names to RGMII on the schematic

jersey99, 2019-05-31:
Match signal names to the elusive RGMII standard. Is this the official [standard](https://web.archive.org/web/20160303171328/http://www.hp.com/rnd/pdfs/RGMIIv2_0_final_hp.pdf)??

michalgaska, 2019-06-03:
Done

ldoolitt, 2019-06-03:
I see two symbols and three pages of schematics updated with commit 0293096. But the formal symbol for ETH_PHY is not updated.

ldoolitt, 2019-06-13:
Confirmed fixed in commit 1b3995c.

Closed 2019-06-13.

Thread 41 (2019-05-31):

add u.fl

gkasprow, 2019-05-31:
add u.fl connectors  to the MGT clock

ldoolitt, 2019-05-31:
Specifically a pair of U.Fl as an option for MGT_CLK_0.

michalgaska, 2019-06-03:
Can it be MGT_CLK_1?
It is much easier to route.

ldoolitt, 2019-06-03:
Michal -

On Mon, Jun 03, 2019 at 05:07:08AM -0700, michalgaska wrote:
> Can it be MGT_CLK_1?

Yes, as long as MGT_CLK_0 can still come from the WR clock.

> It is much easier to route.

OK.  I only chose MGT_CLK_0 because MGT_CLK_1 already had three options.
Three and three seemed more likely to allow short stubs compared to
four and two.

  - Larry

ldoolitt, 2019-06-03:
I see this implemented in commit 02930969. Thanks @michalgaska!

Closed 2019-06-03.

Thread 43 (2019-06-14):

DRC fail: Unconnected trace DDR3_ODT

yetifrisstlama, 2019-06-14:
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

michalgaska, 2019-06-17:
Thank you!
I have already fixed it.

Closed 2019-10-10.

Thread 45 (2019-10-09):

Marble-Mini release schematic

jersey99, 2019-10-09:
@ldoolitt @michallgaska Can one of you generate the latest schematic (in .pdf) and create a github release?

If this hasn't changed from the last release, please close the issue.

Thanks!

yetifrisstlama, 2019-10-10:
https://github.com/BerkeleyLab/Marble/releases/tag/v1.0rc3

Closed 2019-10-10.

Thread 46 (2019-11-13):

Required hardware patches to the first version of Marble

michalgaska, 2019-11-13:
- USB FTDI - reset pin connect to VUSB
- remove R225
- remove F1 and F2
- rotate LEDs
- FPGA JTAG connector - pin 2 connects to P2V5
- wrong transistors, BSS139 -> BSS138
- change S25FL128S to S25FL128SAGMFIR01

yetifrisstlama, 2020-05-02:
> USB FTDI - reset pin connect to VUSB

It is connected to VUSB right now, where should it connect to instead?

ldoolitt, 2020-05-02:
Michael -

On Fri, May 01, 2020 at 06:16:26PM -0700, M. Betz wrote:
> > USB FTDI - reset pin connect to VUSB
> It is connected to VUSB right now, where should it connect to instead?

At least some of thse bugs may have been fixed in

commit ea1216ff2fbc74d5afe56203d6e5192d8b450fb0
Author: michalgaska <michalgaska2@gmail.com>
Date:   Wed Nov 13 08:16:37 2019 +0100

    applied all required amendments to the project

  - Larry

yetifrisstlama, 2020-05-02:
> remove F1 and F2
These are still `FUS0603_BOURNS-SF-0603F050-2`. Shall they be replaced by 10 Ohm resistors? Which footprint?

> rotate LEDs
Not sure how to confirm that one, maybe Michal can comment if he fixed it.

I could confirm all others have been fixed.

ldoolitt, 2020-05-30:
We've also learned that the PM I2C bus (attached to the microcontroller) is missing pull-ups.
Fixed in the design in commit 078b7900.
Patching hardware is possible with clip-leads using Pmod for the +3V3, and tying in to SCL and SDA using J9.

ldoolitt, 2020-06-24:
Also see issues #59 (Fan connectors not functioning) and #60 (Annoying MMC reset behavior).

Closed 2020-09-15.

Thread 47 (2020-02-28):

Unclear which capacitors are populated on MGT_CLK_*_P/N lines

jersey99, 2020-02-28:
The schematic doesn't provide any information to the user about which of the capacitors on the lines are populated.

I can confirm that C296 and C297 are placed, because I can drive the transceiver with 125MHz clock on FPGA_REF_CLK1_P/N

Sidenote: It is slightly confusing that FPGA_REF_CLK1 goes to MGT_REF_0 .. Not a big deal I suppose.

ldoolitt, 2020-03-06:
With enough clicking on the live schematic (not a PDF rendering!) you can find out how components are tagged for build options, and figure this out based on the [KiBoM](https://github.com/SchrodingersGat/KiBoM) documentation.  I agree, this is too indirect to be considered "clear".  Maybe we shouldn't try to fix this ourselves, without help or at list advice from the KiBoM community?

ldoolitt, 2020-05-27:
Fixed as of commit 078fe5ad.  Thanks @yetifrisstlama!

Closed 2020-05-27.

Thread 48 (2020-03-06):

Updates targeting next fab run

ldoolitt, 2020-03-06:
If any of these are complex or controversial and need discussion, maybe start a separate issue and remove them from this checklist.  This list may not be complete, because some features of the board related to the MMC have not yet been tested.  I claim that ignorance shouldn't hold back making the changes we know about.

Clear errata hand-fixed on prototypes (see also #46):
* [x] USB FTDI - reset pin connect to VUSB
* [x] mark R225 as DNF
* [x] rotate LEDs
* [x] FPGA JTAG connector pin connect to P2V5
* [x] wrong transistors, BSS139 -> BSS138
* [x] change S25FL128S to S25FL128SAGMFIR01

Improvements:
* [x] add direct-attach LED or two to FPGA, maybe one on interrupt line to MMC?
* [x] replace F1 and F2 with Micrel MIC2090-1 or similar
* [x] add on-board SiLabs oscillator as option for MGT_CLK_0
* [x] add 330 Ohm series resistor to all four FMC GA pins
* [x] add power meter (another IN219) on 12V bulk input
* [x] move parts between sides to reduce number of reels used in loading (moving 13 components could save 13 reels: C2 C42 C374 D1 D2 Q2 Q19 R58 R66 R103 R104 R108 R160)
* [x] U4 (88E1512 Ethernet PHY): VDDO_SEL (10) should be tied low for VDDO = 2.5V
* [x] remove stray via at (272.35, 172.53)
* [x] more (labeled) test points, especially power supplies

Improvements that don't actually change copper:
* [x] NAD builds can mark S1 as DNF
* [x] AMC builds should mark Pmod J12, J13, J16 as DNF
* [x] mark SFP TX_DIS pulldown resistors as 0 Ohm DNF: R84 R105 R185 R187
* [x] update branding/naming on silkscreen
* [x] more labels in general, e.g., DONE by associated LED
* [x] much bigger silkscreen labels for user-facing parts: J9, J10, J11, J12, J13, J14, J15, J16, S1, SW1, SW2, SW3, M1, M2
* [x] schematic: clarify/unify net names +3.3VP (power), 3V3PM (AMC), +3V3MP (many)
* [x] increase voltage rating of capacitors attached to +12V bus to 25V (some are 16V now)

Discarded ideas:
* move U29 (I2C thermometer) to other end of board, near VCXOs
* add physical power switch (includes barrel and PoE but not AMC?)

yetifrisstlama, 2020-05-01:
More wishlist items collected from `marble1/todo`

- [ ]  add rubber feet (with designated location) for desk use
- [ ]  add mounting holes (standoffs)? (overlap with rubber feet)
- [ ]  use 10 Ohm instead of F1 and F2
- [ ]  reduce BOM line count in general, push-buttons in particular
- [ ]  if keeping J14 "Cortex Debug Connector" make a big pin-1 marking can we use a keyed/shrouded option for J14? Amphenol 20021221-00010C4LF
- [ ]  improve testability in general
- [ ]  improve documentation of build options

ldoolitt, 2020-05-07:
As of fab2 branch commit 9ce94581, I have moved seven parts (C374, D1, D2, R58, R66, R103, R160) between sides, to cut back the number of reels needed in assembly.

One group of tasks, that should at least be studied together, is to rework the +12V bus:

* add physical power switch (includes barrel and PoE but not AMC?)
* add power meter (another IN219) on 12V bulk input
* move parts between sides, the perfect-diode circuit from barrel J1: Q1 Q2 R104 R107 R108

After that, the only remaining parts that I want to move are C2 C42 Q19.

ldoolitt, 2020-06-01:
Regarding the @yetifrisstlama comments above: I just ticked off two.

* Reduce BOM count, I shaved it from 128 to 117.  I'm sure it can go lower, but only with a lot more work.
* improve documentation of build options, see the newly visible config attributes and associated documentation on FPGA_MGT.sch.

That leaves Improve testability in general, which I left open. The new 11 test points on power supplies should help some.  If anyone has specific ideas, please comment here or in a new issue.

ldoolitt, 2020-06-02:
Thanks for everyone's persistence and patience!  Closing.

Closed 2020-06-02.

Thread 49 (2020-03-06):

Add mounting holes

ldoolitt, 2020-03-06:
Users of the NAD configuration want a useful mechanism for attaching this board inside their chassis.
Normally that's with standoffs.  We have some preferred coordinates for holes to match a previous FPGA carrier board, but that's negotiable.

To be consistent with the FMC-standard holes, the nominal diameter would be 2.7 mm.  I'd actually like all these holes to be increased to 2.95 mm, to make life easier for U.S. shops that have easy access to 4-40 screws.

These holes would also give a convenient place to stick soft-plastic feet for desk use.

ldoolitt, 2020-05-23:
Commit d5d2528 adds two mounting holes, at (243.37, 175.96) and (227.97, 73.06).
Some of the existing eight FMC mounting holes could also be used for mounting, at least in some use cases.
If any stakeholders want to request additional holes, with rough geographic guidelines, please use this issue.

ldoolitt, 2020-05-27:
Commit fd2c21d increases mounting hole drill size to 2.95mm, close-fit clearance for 4-40 screws.

ldoolitt, 2020-05-30:
Hole placement in mm, native KiCad coordinates as of commit 18da7a807

243.374 -175.96  B12
287.574 -148.16  B13
227.974  -73.16  B11
134.274  -78.16  B8
134.274 -134.71  B1
134.274 -148.16  B2
134.274 -204.71  B4
188.874  -75.66  B7
188.874 -138.66  B5
188.874 -145.66  B6
188.874 -208.66  B3

I have heard informally this is good enough, and it will be hard to add anything much better.
Closing.

ldoolitt, 2020-06-09:
There are some serious sign (coordinate handedness) lurking in here.
TL;DR: the hole  227.974 -73.16 B11, that is supposed to overlap a previous hole pattern, doesn't really.

I've discovered (pretty sure) two things:
* That previous hole pattern had mirrored the FMC hole pattern
* KiCad uses a left-handed coordinate system internally, where Y increases as you move down.
It flips the sign of Y in its export to Gerber and drill files, so those externally visible coordinates are right-handed as expected.

The coordinates in the previous comment, with negative Y values, use the _external_ (right-handed) convention.
Not sure yet how we want to proceed, so I'm re-opening this issue.

ldoolitt, 2020-09-12:
Closing again.
Despite the sign confusion, Tthe earlier comment "it will be hard to add anything much better" still stands.
If someone has a specific complaint or suggestion, they can re-open this issue, or start another one.

Closed 2020-09-12.

Thread 51 (2020-05-02):

Schematic is (slightly) out of sync with layout

yetifrisstlama, 2020-05-02:
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

need to investigate these 5 footprint errors.
B8 is a mounting hole.

yetifrisstlama, 2020-05-04:
There were 3 mounting holes with the same ref. (B8), so I introduced B9 and B10.

B1 - B8 had position offsets on footprint level, which is confusing. So I created new footprints without these offsets and placed them 98d07450e9b919d759f04ddffea60d38d45a186f

I synced everything up with the Symbol library and Schematics b40da07367c702bdcf33b32bf835ca2f972e5a49.

Then I did the `Update PCB from Schematic` again and it passed with 0 warnings, 0 errors 83864cef8cc8df8dba615bdb26b099880a44d3fc

Before I did real changes to the schematic, I just added a label (tiny change) and saved it with Kicad 5.1.5-rc1. I got a huge diff but it didn't look like it broke anything e362454c3b0bab2957f473035f70108d8871f872. This is my working copy now.

Closed 2020-05-04.

Thread 52 (2020-05-06):

C&K HDT0001 not marked as SMD

ldoolitt, 2020-05-06:
Without the SMD: Yes attribute set, it doesn't show up in the .pos file export.
Yes, it really is reflow-solderable.  It has plastic "locating posts" that require a hole in the PCB, but that's not supposed to change the assembly technique.
This part is used as S1 in the design.

yetifrisstlama, 2020-05-07:
fixed in ff041c7d8166ea5fc86e2540e8a1b0b038a7b2e7

Closed 2020-05-07.

Thread 54 (2020-05-19):

mini j-link segger connector

jersey99, 2020-05-19:
It's hard to know which orientation to plug in the segger j-link mini onto the Marble-mini. It would be good if some hints are added, possible options:
1. Add a mating connecter with the segger j-link notch
2. Add a note on the silkscreen. I understand that J16 mark on the silkscreen gives orientation, but a little more indication on the silk screen would help double guessing and having to look at the docs every once in a while.

@ldoolitt @yetifrisstlama this would be a "good to have" before the next spin.

yetifrisstlama, 2020-05-19:
Assuming you mean J14 (MMC JTAG)

This doc about [cortex debug connectors](http://infocenter.arm.com/help/topic/com.arm.doc.faqs/attached/13634/cortex_debug_connectors.pdf) suggests it should be a [`FTSH-110`](http://suddendocs.samtec.com/catalog_english/ftsh_mt.pdf) connector.

Looks like we can just install the shrouded version, if we can come up with the right part number.
FTSH - 110 - ???

Here's some options on digikey which might fit too:
https://www.digikey.com/short/z4fr7m

jersey99, 2020-05-19:
Sorry, yes. To confirm J16 (MMC JTAG).

They all look good to me. :-|

ldoolitt, 2020-05-19:
In the comment added to Issue #48, this shows up as

* if keeping J14 "Cortex Debug Connector" make a big pin-1 marking can we use a keyed/shrouded option for J14? Amphenol 20021221-00010C4LF

This in turn was pasted from the to-do file in the marble1 repo.  So yeah, it's a known issue.
Changing assignment to Michal, since he agreed in a phone call to at least look into making this change.

yetifrisstlama, 2020-05-20:
Note that `20021121-00010C4LF` is not shrouded

I'd recommend: `Samtec FTSH-105-01-L-DV-K-TR`

ldoolitt, 2020-05-20:
> Note that 20021121-00010C4LF is not shrouded

Looks shrouded to me.
At [Digi-Key](https://www.digikey.com/product-detail/en/amphenol-icc-fci/20021221-00010C4LF/609-3700-1-ND/2209154).
This is the part inserted by Michal, which now shows up in fab2 branch.
Both the library and the instance need the SMD attribute set to Yes.

yetifrisstlama, 2020-05-20:
For the `20021121-00010C4LF`, how do we know the notch in the shroud fits the connector? It's hard to tell from the drawing if there is a notch at all.

gkasprow, 2020-05-20:
In such cases I download 3D models and check with FreeCad, Alibre or similar tool if they fit.

yetifrisstlama, 2020-05-20:
Excellent tip!

Looks like there's no notch on `20021221-00010C4LF`

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

ldoolitt, 2020-05-21:
Right.  Shrouded but no notch.  The connector shipped with the Segger demands a notch.
The silkscreen for the footprint should also show the notch, so its chance of getting assembled right is more than 0.5.

The FTSH-105-01-L-DV-K-TR you mentioned earlier looks a little funny, and is three times the price, but will probably work.

yetifrisstlama, 2020-05-21:
The `FTSH-105-01-L-DV-K-TR ` is the debug header recommended by ARM. I guess that's also why it's :moneybag::moneybag::moneybag:

ldoolitt, 2020-05-22:
FTSH-105-01-L-DV-K-TR placed as of commit f78131c.

Closed 2020-05-22.

Thread 56 (2020-05-23):

Keep some I2C busses running with only +3V3P

ldoolitt, 2020-05-23:
Even when the "main" power is shut off with EN_PSU_CH or OVER_TEMP, the microcontroller should be able to run basic services like sense temperatures and read FMC ID EEPROM.

As of now (commit d5d2528) this is partially implemented, thanks to @michalgaska and particularly his addition of U46 TCA9517.

Reading FMC ID EEPROM requires the bus mux U5 and the FMC 3V3VAUX to be powered by +3V3P, which is done.  Still to-do

* [x] Move pull-ups R45 R46 R47 R48 to +3V3P

Keeping the I2C_APP bus running, so the microcontroller can see the input voltage (presumably its current is close to zero), requires

* [x] Change U34 U39 (PCA9555) supply to +3V3P

Want to check other things, like

* [x] Should I2C_FPGA_SW_RESET and EXP_INT be isolated from the FPGA like SCL and SDA?

gkasprow, 2020-05-23:
One can use such a circuit to isolate the I2C busses
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

ldoolitt, 2020-05-23:
@gkasprow, can you elaborate on how to use that circuit?  I can try to reverse engineer it: It looks like EEM0_I2C is the always-on side, and the I2C0_{SDA,SCL} side can be left powered off if P12V0A is "low".  Turning this gate on requires 12V0A that is between 2 and 20 V higher than P3V3. With some work, we could probably create such a control signal for our board.

gkasprow, 2020-05-23:
These are two independent circuits. The right side is always on, left is connected when the main power is available. 12V makes sure that both FETs are open both for L and H. Even with the left side shorted to GND, the right side still works, because diodes in FETs are not conduction. Of course, the right side needs pullups to P3V3_MP

ldoolitt, 2020-05-25:
@gkasrpow, I must be missing something about your explanation.  If the left side is shorted to ground, I see protection diodes in each N-FET that will pull the right side down.  If the left side "just" has protection diodes to ground, maybe that's OK, the right side can get pulled up to around 1.4V.

Is this cheaper/faster/smaller than the TCA9517? That part has an under-voltage lock-out, plus an enable input (not yet used, but could be plausibly be hooked to a P_GOOD signal from the "main" 3.3V supply) .

gkasprow, 2020-05-25:
Yes, this TCA is a better option. I used transistors because I didn't want to add another item to the BOM. The transistor option isolates the only one side and was used to disconnect part of the I2C rail supplied from 3V3. If the left side is shorted (by non-powered 3V3 which is derived from non-powered 12V) nothing happens because substrate diodes are not conducting and FETs are in the off state. When 12V is present, 3V3 rail is present as well.

ldoolitt, 2020-06-01:
I'm marking this done as of commit 8f30f0a6, where a second TCA9517 has been added to isolate I2C_FPGA_SW_RST and EXP_INT from an un-powered FPGA. If anyone reviewing the schematics discovers something we missed, please re-open this issue. Of course it will remain to be verified in hardware.

Closed 2020-06-01.

Thread 57 (2020-05-27):

Missing I2C pull-up resistors on I2C PM bus

smpaiagua, 2020-05-27:
There are pull-up resistors on the IPMB and FPGA I2C busses but not on the PM bus, making it inaccessible from the microcontroller. This issue was encountered when checking out I2C connectivity in one of the original Marble Mini boards.

A temporary workaround is to use the J9 connector to clip on the necessary pull-up resistors.

ldoolitt, 2020-05-27:
Fixed for the next rev in commit 078b7900.  Let's leave the issue open until at least one of the existing prototypes is patched and confirmed working.

ldoolitt, 2020-05-28:
PM I2C bus is demonstrated to work when patched with pull-ups, so the fix is hardware-proven.
I'm closing the issue, even though we have five un-patched prototypes out there.

Closed 2020-05-28.

Thread 58 (2020-05-28):

I2C Mux bitmap contains misleading address for XRP7724

smpaiagua, 2020-05-28:
I haven't checked if this has been updated since, but in my version (465553a79b639eb63c9b31dbba8ec8271f020407) the I2C address for XRP7724 is shown in the bitmap as being 0x28. This address is the chip's 7-bit address. The legend at the bottom suggests that all I2C address are 8-bit (RW=0). To maintain consistency XRP7724 should be listed as 0x50.

ldoolitt, 2020-05-28:
Fixed in commit 623f0899

Closed 2020-05-28.

Thread 59 (2020-06-15):

Fan connectors not functioning

ldoolitt, 2020-06-15:
Fan connectors M1 and M2 don't spin fans. I don't claim to fully understand the situation.
I'm pretty sure pins 1 and 3 are swapped, but in my limited testing with that swap un-done, the fan still didn't spin.
It looks like U27 MAX6639 comes up by default at 50% duty factor.  In order to monitor and adjust its behavior on the prototype boards, you need to work around issue #57 (not so hard with clip leads and thru-hole resistors).  We have proof-of-concept MMC code that can manipulate this chip over I2C at  https://gitlab.lbl.gov/spaiagua/marble_mmc.

gkasprow, 2020-06-15:
you can have a look at Booster design where this chip works.
https://github.com/sinara-hw/Booster/releases
Main Board design, page 13

ldoolitt, 2020-06-18:
I have a report from @michallgaska  indicating that pins 1 and 3 are indeed swapped in the current (commit bbb0a2e2) design.  Un-flipping those pins makes a fan work.

ldoolitt, 2020-06-24:
Fixed in the fab2 branch in commit 0453e1eb.
Existing prototypes could be reworked by rotating the fan headers 180 degrees.

Closed 2020-06-24.

Thread 60 (2020-06-15):

Annoying MMC reset behavior

ldoolitt, 2020-06-15:
On every USB connection to the FT4232 UART attached to the MMC (/dev/ttyUSB3 on Linux),
the DTR line is asserted and the MMC gets reset.  Having some ability to reset the MMC via USB is clearly a helpful feature, but it shouldn't be a mandatory side effect of attaching to the UART.
We've searched for a way to not trigger a reset using FT4232 features, and come up short.

Our colleagues at LNLS found similar behavior on one of their boards, and ended up using a XNOR gate on DTR and RTS to generate the reset.  That empirically works; the skew between DTR and RTS on a connection event is small enough that an 0.1 ms RC filter on the output of the XNOR gate can avoid spurious resets.

Would it also work to move the reset logic on DTR from port D to port B (currently unused)?

gkasprow, 2020-06-15:
IN AFCZ design I added a SMT "DIP" switch to solve that issue.

yetifrisstlama, 2020-06-15:
Does it happen when plugging in the cable or when opening the UART?

It's a workaround but in miniterm.py you can set the initial state of the
DTR line:

miniterm.py /dev/ttyUSB3 115200 --dtr 0/1

I wonder if that would help.

I like the XOR idea!

Am Mo., 15. Juni 2020 um 06:45 Uhr schrieb Greg Kasprowicz <
notifications@github.com>:

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

gkasprow, 2020-06-15:
Look at this circuit. I had an issue with resetting MMC while USB insertion. It was caused by FET capacitance
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

ldoolitt, 2020-06-15:
That's the circuit we use now.  No problems on USB insertion.  MMC goes into reset when you attach a terminal program.  I don't have a board in front of me; someone else needs to try @yetifrisstlama 's miniterm.py recipe.

gkasprow, 2020-06-15:
OK, I use Termite and don't have issues, but colleagues who use Linux report such a problem. That's why I added the switch. Make sure that when you add some logics, the default flashing utility will still work.

smpaiagua, 2020-06-15:
I can confirm that while this doesn't work:
`miniterm.py /dev/ttyUSB3 115200 --dtr 0`

This does:
`miniterm.py /dev/ttyUSB3 115200 --dtr 0 --rts 0`

Which is what I've been doing manually with gtkterm.

Thanks for the workaround @yetifrisstlama !

ldoolitt, 2020-06-15:
> In AFCZ design I added a SMT "DIP" switch to solve that issue.

I can't find such a DIP switch in my copy of the AFCZ schematic.  Is that version of the design published somewhere?

gkasprow, 2020-06-15:
It's on the MMC schematic
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

smpaiagua, 2020-06-15:
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

Unfortunately while this makes it easier to connect to the MMC, there's still a reset glitch when opening the connection. This reminded me of a long-running pyserial thread I ran into when I first encountered this issue:
[DTR and RTS control lines toggle unintentionally when opening port](https://github.com/pyserial/pyserial/issues/124)

Palmitoxico, 2020-06-16:
The Linux kernel will raise the DTR and RTS lines (lower in logic levels) every time a program successfully opens a serial port, causing a reset if one of these signals is connected directly to the microcontroller reset pin. This is a kernel behaviour and can not be changed by a userland application:

https://github.com/torvalds/linux/blob/a5dc8300df75e8b8384b4c82225f1e4a0b4d9b55/drivers/tty/tty_port.c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

https://github.com/torvalds/linux/blob/a5dc8300df75e8b8384b4c82225f1e4a0b4d9b55/drivers/tty/tty_port.c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

https://github.com/torvalds/linux/blob/a5dc8300df75e8b8384b4c82225f1e4a0b4d9b55/drivers/tty/tty_port.c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

You could patch your kernel to avoid this behaviour (just comment out the contents of the tty_port_raise_dtr_rts function, it works but it isn't a elegant solution).

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

It will reset the microcontroller, but the terminal application will lower DTR and RTS (raise in logic levels) as soon it opens the serial port so the microcontroller restarts, unless there is a sufficiently  large RC filter that prevents this (from my measurements, it takes about ~2ms to change the DTR/RTS signals back when using USB-to-Serial converters, but I wouldn't consider it a reliable delay).

As mentioned by @ldoolitt we at LNLS have dealt with this problem using a XNOR gate between DTR and RTS and a small RC filter as DTR and RTS don't change exactly at the same time:

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

ldoolitt, 2020-06-24:
Supposedly fixed for the next batch (in the fab2 branch) commit 0f366d635, by moving RTS_OUT and DTR_OUT from U23 (FT4232) bank D to bank B.
This is something retrofittable on the first batch, by someone skilled with cutting traces and adding white wires.
That would allow testing this fix for unwanted side effects.

Closed 2020-06-24.

Thread 62 (2020-08-20):

Pmod guidelines

ldoolitt, 2020-08-20:
According to [How to Design a Pmod – Best Practices](https://blog.digilentinc.com/how-to-design-a-pmod-best-practices/) (by Talesa Bleything, 2017-11-29) FPGA boards like this should "include ESD protection diodes and 200-ohm series resistors on the I/O pins in order to limit short circuit currents and driver conflicts." The current Marble-Mini does not do that.  This puts it in the category, also mentioned in that article, of a “high speed” Pmod port, where the Pmod pins are directly attached to the FPGA.

At least this situation should be documented.  It's worth considering if we should add the series resistors and protection diodes on a future revision.

Thread 66 (2020-12-08):

12V current monitoring sign reversed

ldoolitt, 2020-12-08:
U43, the INA219 monitoring the main +12V input voltage and current, has its IN+ and IN- pins reversed.
Current drawn by the board results in negative current readings.
It looks like the INA219 doesn't care, but humans and software might consider this unexpected or wrong.
