BerkeleyLab/Marble-Mini/AMC_FMC_Carrier-PcbDoc.sch

## KiCad design AMC_FMC_Carrier-PcbDoc.sch (2020-09-25)

Schematic: AMC_FMC_Carrier-PcbDoc.sch

Parts:
B1, B2, B3, B4, B5, B6, B7, B8, B11, B12, B13: PLATED_HOLE2.7_PAD5.0; HOLE2.7_PAD5.0; Part Number PLATED_HOLE2.7_PAD5.0
B9: SLOT_2_11; HOLE2_SLOT11
B10: PLATED_HOLE2.8_PAD0; HOLE2.8_PAD0
FTG1, FTG2: FIDUCIAL_TARGET_C100-200; FIDUCIAL_TOP_S200-400; Part Number FIDUCIAL_TARGET_C100-200
FTG3: FIDUCIAL_TARGET_C100-200; FIDUCIAL_BOT_S200-400; Part Number FIDUCIAL_TARGET_C100-200
FTG4: Pads:FIDUCIAL_BOT_S200-400; FIDUCIAL_BOT_S200-400; Part Number FIDUCIAL_TARGET_C100-200
R243, R244: R1206_1M_1%_0.25W_100PPM; RESC3216X65N; Tolerance ±1%; Part Number R1206_1M_1%_0.25W_100PPM
S1: HDT0001; Manufacturer Part Number HDT0001; Mouser Part Number 611-HDT0001

Notes on the sheet:
DDR3
FMC 2
FMC 1
SFP1
SFP2
SFP3
SFP4
ETHERNET
PMOD
White Rabbit
JTAG
MISC
CLK
AMC holes not grounded
Marble-Mini
