BerkeleyLab/Marble-Mini/AMC_connector.sch

## KiCad design AMC_connector.sch (2020-09-25)

Schematic: AMC_connector.sch

Parts:
D1: SS16; DIOM5127X229N; Voltage 60V; Part Number SS16
P3: CMP-0001-00058-2; AMC-GF-2D-750-O274

Notes on the sheet:
RSRVD6
RSRVD8
