BerkeleyLab/Marble-Mini/ETH_PHY.sch

## KiCad design ETH_PHY.sch (2020-09-25)

Schematic: ETH_PHY.sch

Parts:
C41, C43, C44, C45, C46, C48, C49, C50, C51, C52, C53, C54, C55, C56, C58, C59, C60, C79, C352: CC0201_100NF_6.3V_10%_X5R; CAPC0603X33N; Voltage 6.3V; Tolerance ±10%; Part Number CC0201_100NF_6.3V_10%_X5R
C42, C47: CC0603_10UF_6.3V_20%_X5R; CAPC1608X87N; Voltage 6.3V; Tolerance ±20%; Part Number CC0603_10UF_6.3V_20%_X5R
C57: CC0603_4.7UF_25V_10%_X5R; CAPC1709X95N; Voltage 25V; Tolerance ±10%; Part Number CC0603_4.7UF_25V_10%_X5R
C374, C375: CC0402_100PF_50V_5%_C0G; CAPC1005X55N; Voltage 50V; Tolerance ±5%; Part Number CC0402_100PF_50V_5%_C0G
J4: BELFUSE_0826-1X1T-HS-F; BELFUSE_0826-1X1T-80-F; Part Number BELFUSE_0826-1X1T-HS-F
L3, L4: IND0603_MURATA_BLM18SG121TN1D; INDC1608X65N; Tolerance ±25%; Part Number IND0603_MURATA_BLM18SG121TN1D
OSC1: 25MHz; OSC_MICREL_2520
R62, R64: R0402_5K1_1%_0.0625W_100PPM; RESC1005X40N; Tolerance ±1%; Part Number R0402_5K1_1%_0.0625W_100PPM
R65, R165: R0402_0R_JUMPER; RESC1005X40N; Part Number R0402_0R_JUMPER
R66: R0603_4K99_1%_0.063W_50PPM; RESC1608X55N; Tolerance ±1%; Part Number R0603_4K99_1%_0.063W_50PPM
R67, R156: R0402_240R_1%_0.0625W_100PPM; RESC1005X40N; Tolerance ±1%; Part Number R0402_240R_1%_0.0625W_100PPM
R262: R0402_10K_1%_0.0625W_100PPM; RESC1005X40N; Tolerance ±1%; Part Number R0402_10K_1%_0.0625W_100PPM
R291, R292, R293, R294, R295, R296: R0402_22R_1%_0.0625W_100PPM; RESC1005X40N; Tolerance ±1%; Part Number R0402_22R_1%_0.0625W_100PPM
U4: 88E1512-XX-NNP2I000; QFN50P800X800X100-57N-S437; Part Number 88E1512-XX-NNP2I000
U6: TXS0102DCUR; SOP50P310X90-8N; Part Number TXS0102DCUR

Notes on the sheet:
Clock source option
