BerkeleyLab/Marble-Mini/FMC_1.sch

## KiCad design FMC_1.sch (2020-09-25)

Schematic: FMC_1.sch

Parts:
C61: CC0402_100NF_25V_10%_X5R; CAPC1005X55N; Voltage 25V; Tolerance ±10%; Part Number CC0402_100NF_25V_10%_X5R
C62: CC0805_22UF_25V_20%_X5R; CAPC2012X135N; Voltage 25V; Tolerance ±20%; Part Number CC0805_22UF_25V_20%_X5R
C63, C64, C65, C66, C67: CC0201_100NF_6.3V_10%_X5R; CAPC0603X33N; Voltage 6.3V; Tolerance ±10%; Part Number CC0201_100NF_6.3V_10%_X5R
C68, C69: CC0603_10UF_6.3V_20%_X5R; CAPC1608X87N; Voltage 6.3V; Tolerance ±20%; Part Number CC0603_10UF_6.3V_20%_X5R
P1: SAMTEC_ASP-134603-01; Part Number SAMTEC_ASP-134603-01
R234, R260: R0402_10K_1%_0.0625W_100PPM; RESC1005X40N; Tolerance ±1%; Part Number R0402_10K_1%_0.0625W_100PPM
R261: R0402_1K_1%_0.0625W_100PPM; RESC1005X40N; Tolerance ±1%; Part Number R0402_1K_1%_0.0625W_100PPM
R297, R298: R0402_240R_1%_0.0625W_100PPM; RESC1005X40N; Tolerance ±1%; Part Number R0402_240R_1%_0.0625W_100PPM
U45: MIC2090-1YM5TR; SOT95P280X145-5N; Part Number MIC2090-1YM5TR

Notes on the sheet:
LA18_CC_P LA18_CC_N
LA1_CC_P LA1_CC_N
LA17_CC_P LA17_CC_N
LA0_CC_P LA0_CC_N
FMC1_VREF_A_M2C
FMC1_DP0_C2M_P
FMC1_DP0_C2M_N
FMC1_DP0_M2C_P
FMC1_DP0_M2C_N
GA0_1
GA1_1
