BerkeleyLab/Marble-Mini/FMC_2.sch

## KiCad design FMC_2.sch (2020-09-25)

Schematic: FMC_2.sch

Parts:
C5: CC0402_100NF_25V_10%_X5R; CAPC1005X55N; Voltage 25V; Tolerance ±10%; Part Number CC0402_100NF_25V_10%_X5R
C6: CC0805_22UF_25V_20%_X5R; CAPC2012X135N; Voltage 25V; Tolerance ±20%; Part Number CC0805_22UF_25V_20%_X5R
C7, C8, C9, C10, C11: CC0201_100NF_6.3V_10%_X5R; CAPC0603X33N; Voltage 6.3V; Tolerance ±10%; Part Number CC0201_100NF_6.3V_10%_X5R
C12, C13: CC0603_10UF_6.3V_20%_X5R; CAPC1608X87N; Voltage 6.3V; Tolerance ±20%; Part Number CC0603_10UF_6.3V_20%_X5R
P2: SAMTEC_ASP-134603-01; Part Number SAMTEC_ASP-134603-01
R205, R258: R0402_10K_1%_0.0625W_100PPM; RESC1005X40N; Tolerance ±1%; Part Number R0402_10K_1%_0.0625W_100PPM
R259: R0402_1K_1%_0.0625W_100PPM; RESC1005X40N; Tolerance ±1%; Part Number R0402_1K_1%_0.0625W_100PPM
R299, R300: R0402_240R_1%_0.0625W_100PPM; RESC1005X40N; Tolerance ±1%; Part Number R0402_240R_1%_0.0625W_100PPM
U44: MIC2090-1YM5TR; SOT95P280X145-5N; Part Number MIC2090-1YM5TR

Notes on the sheet:
LA18_CC_P LA18_CC_N
LA1_CC_P LA1_CC_N
LA0_CC_P LA0_CC_N
LA17_CC_P LA17_CC_N
FMC2_DP0_C2M_P
FMC2_DP0_C2M_N
FMC2_DP0_M2C_P
FMC2_DP0_M2C_N
FMC2_VREF_A_M2C
GA0_2
GA1_2
