BerkeleyLab/Marble-Mini/FPGA.sch

## KiCad design FPGA.sch (2020-09-25)

Schematic: FPGA.sch

Parts:
C215, C342: CC0201_100NF_6.3V_10%_X5R; CAPC0603X33N; Voltage 6.3V; Tolerance ±10%; Part Number CC0201_100NF_6.3V_10%_X5R
LD11, LD12: LED_AVAGO_HSMC-C120; Part Number LED_AVAGO_HSMC-C120
R199: R0402_2K2_1%_0.0625W_100PPM; RESC1005X40N; Tolerance ±1%; Part Number R0402_2K2_1%_0.0625W_100PPM
R264, R265: R0402_1K_1%_0.0625W_100PPM; RESC1005X40N; Tolerance ±1%; Part Number R0402_1K_1%_0.0625W_100PPM
U34, U39: PCA9555AHF; QFN50P400X400X80-25N-S225; Part Number PCA9555AHF

Notes on the sheet:
0x42
0x44
