BerkeleyLab/Marble-Mini/FPGA_13_14.sch

## KiCad design FPGA_13_14.sch (2020-09-25)

Schematic: FPGA_13_14.sch

Parts:
C38, C39, C78: CC0201_100NF_6.3V_10%_X5R; CAPC0603X33N; Voltage 6.3V; Tolerance ±10%; Part Number CC0201_100NF_6.3V_10%_X5R
R209, R210, R224, R225, R227: R0402_0R_JUMPER; RESC1005X40N; Part Number R0402_0R_JUMPER
R221, R222: R0402_1K_1%_0.0625W_100PPM; RESC1005X40N; Tolerance ±1%; Part Number R0402_1K_1%_0.0625W_100PPM
R223: R0402_2K2_1%_0.0625W_100PPM; RESC1005X40N; Tolerance ±1%; Part Number R0402_2K2_1%_0.0625W_100PPM
SW1: SW_DIP_x01; SW_OMRON_A6SN-1101; Manufacturer Part Number A6SN-1101
U1: XC7A100T-2FGG484C; BGA484C100P22X22_2300X2300X240; Manufacturer Part Number XC7A100T-2FGG484C
U11: SN74LVC1G125DCKT; SOT65P210X110-5N; Part Number SN74LVC1G125DCKT
U30: S25FL128SAGMFIR01; SOIC127P1030X265-16N; Manufacturer Part Number S25FL128SAGMFIR01
