BerkeleyLab/Marble-Mini/FPGA_15_16.sch

## KiCad design FPGA_15_16.sch (2020-09-30)

Schematic: FPGA_15_16.sch

Parts:
C37, C376, C377, C381, C382, C387, C388: CC0201_100NF_6.3V_10%_X5R; CAPC0603X33N; Voltage 6.3V; Tolerance ±10%; Part Number CC0201_100NF_6.3V_10%_X5R
C103: CC0603_4.7UF_25V_10%_X5R; CAPC1709X95N; Voltage 25V; Tolerance ±10%; Part Number CC0603_4.7UF_25V_10%_X5R
C104: CC0805_4.7UF_10V_10%_X5R; CAPC2012X135N; Voltage 10V; Tolerance ±10%; Part Number CC0805_4.7UF_10V_10%_X5R
D10, D11: HDMIULC6-4SC6; SOT95P280X145-6N; Voltage 6V; Part Number HDMIULC6-4SC6
J15: 10029449-111RLF; Part Number SAMTEC_MHDMR-19-02-H-TH-L-TR
LD16, LD17: LED_KINGBRIGHT_KPH-1608CGCK; Part Number LED_KINGBRIGHT_KPH-1608CGCK
Q20, Q21: BSS138LT1G; SOT95P240X110-3N; Part Number BSS138LT1G
R141, R164, R206, R207, R208, R211, R219, R226: R0402_51R_1%_0.0625W_100PPM; RESC1005X40N; Tolerance ±1%; Part Number R0402_51R_1%_0.0625W_100PPM
R217, R218, R220, R304, R305, R311, R312: R0402_2K2_1%_0.0625W_100PPM; RESC1005X40N; Tolerance ±1%; Part Number R0402_2K2_1%_0.0625W_100PPM
R306, R307: R0402_1K_1%_0.0625W_100PPM; RESC1005X40N; Tolerance ±1%; Part Number R0402_1K_1%_0.0625W_100PPM
R313: R0402_0R_JUMPER; RESC1005X40N; Part Number R0402_0R_JUMPER
U1: XC7A100T-2FGG484C; BGA484C100P22X22_2300X2300X240; Manufacturer Part Number XC7A100T-2FGG484C
U12: MC78L05ACDR2G; SOIC127P600X175-8N; Part Number MC78L05ACDG
U42: SN65MLVD2DRBT; SON50P300X300X80-9N-R175X248; Manufacturer Part Number SN65MLVD2DRBT
U46, U47: TCA9517DGKR; SOP65P490X110-8N; Part Number TCA9517DGKR
