BerkeleyLab/Marble-Mini/FPGA_MGT.sch

## KiCad design FPGA_MGT.sch (2020-09-25)

Schematic: FPGA_MGT.sch

Parts:
C288, C289, C290, C291, C292, C293, C294, C295, C296, C297, C298, C299, C300, C301, C302, C303, C304, C305, C306, C307, C308, C309, C310, C311, C312, C313, C314, C315, C316, C317, C318, C319, C320, C321, C322, C323, C324, C325, C326, C327, C328, C329, C378, C379, C385, C386: CC0201_100NF_6.3V_10%_X5R; CAPC0603X33N; Voltage 6.3V; Tolerance ±10%; Part Number CC0201_100NF_6.3V_10%_X5R
J2, J5: HIROSE_U.FL-R-SMT-1(10); U.FL_Hirose_U.FL-R-SMT-1_Vertical; Part Number HIROSE_U.FL-R-SMT-1(10)
R59, R60, R61, R169: R0201_200R_1%_0.05W_200PPM; RESC0603X28N; Tolerance ±1%; Part Number R0201_200R_1%_0.05W_200PPM
U1: XC7A100T-2FGG484C; BGA484C100P22X22_2300X2300X240; Manufacturer Part Number XC7A100T-2FGG484C

Notes on the sheet:
config fields / PCB variants
no annotation
dnf
-standalone
fit the capacitor in any case
do not fit the capacitor
dnf when assembling standalone variant
+standalone
fit only for standalone variant
AMC port
default
gigabit clock 1 from
CDCM61004
gigabit clock 0 from
4 x SFP modules
standalone
U.FL connector (J2, J5)
CDCM61004 (U20)
8 x gigabit lanes to
