BerkeleyLab/Marble-Mini/FPGA_PWR&MISC.sch

## KiCad design FPGA_PWR&MISC.sch (2020-09-25)

Schematic: FPGA_PWR&MISC.sch

Parts:
C1, C222, C225, C280, C281, C282, C283: CC0603_22UF_6.3V_20%_X5R; CAPC1709X100N; Voltage 6.3V; Tolerance ±20%; Part Number CC0603_22UF_6.3V_20%_X5R
C2, C239, C265, C266: CC1210_100UF_6.3V_20%_X5R; CAPC3225X270N; Voltage 6.3V; Tolerance ±20%; Part Number CC1210_100UF_6.3V_20%_X5R
C3, C4, C216, C223, C226, C227, C228, C229, C231, C244, C245, C246, C247, C248, C249, C250, C251, C256, C257, C258, C259, C260, C261, C262, C263, C264, C267, C269, C271, C273, C275, C277, C279, C332, C333, C334, C335, C336, C337, C338, C339: CC0201_470NF_4V_20%_X5R; CAPC0603X33N; Voltage 4V; Tolerance ±20%; Part Number CC0201_470NF_4V_20%_X5R
C217, C218, C219, C220, C221, C224, C230, C232, C234, C236, C238: CC0201_100NF_6.3V_10%_X5R; CAPC0603X33N; Voltage 6.3V; Tolerance ±10%; Part Number CC0201_100NF_6.3V_10%_X5R
C233, C235, C237, C240, C241, C242, C243, C252, C253, C254, C255, C268, C270, C272, C274, C276, C278, C284, C285, C286, C287: CC0805_4.7UF_10V_10%_X5R; CAPC2012X135N; Voltage 10V; Tolerance ±10%; Part Number CC0805_4.7UF_10V_10%_X5R
L27, L28: IND0603_MURATA_BLM18SG121TN1D; INDC1608X65N; Tolerance ±25%; Part Number IND0603_MURATA_BLM18SG121TN1D
LD3: LED_KINGBRIGHT_KPH-1608CGCK; Part Number LED_KINGBRIGHT_KPH-1608CGCK
PB1: PB_TYCO_FSM2JSMA; Part Number PB_TYCO_FSM2JSMA
Q19: BSS138LT1G; SOT95P240X110-3N; Part Number BSS138LT1G
R159, R286, R287, R288: R0402_0R_JUMPER; RESC1005X40N; Part Number R0402_0R_JUMPER
R160: R0402_2K2_1%_0.0625W_100PPM; RESC1005X40N; Tolerance ±1%; Part Number R0402_2K2_1%_0.0625W_100PPM
R161: R0402_100R_1%_0.1W_100PPM; RESC1005X40N; Voltage 50V; Tolerance ±1%; Part Number R0402_100R_1%_0.1W_100PPM
R162: R0402_300R_1%_0.0625W_100PPM; RESC1005X40N; Tolerance ±1%; Part Number R0402_300R_1%_0.0625W_100PPM
R163, R283, R284, R285: R0402_1K_1%_0.0625W_100PPM; RESC1005X40N; Tolerance ±1%; Part Number R0402_1K_1%_0.0625W_100PPM
R282: R0402_5K1_1%_0.0625W_100PPM; RESC1005X40N; Tolerance ±1%; Part Number R0402_5K1_1%_0.0625W_100PPM
U1: XC7A100T-2FGG484C; BGA484C100P22X22_2300X2300X240; Manufacturer Part Number XC7A100T-2FGG484C
