BerkeleyLab/Marble-Mini/I2C_MUX.sch

## KiCad design I2C_MUX.sch (2020-09-25)

Schematic: I2C_MUX.sch

Parts:
C40: CC0201_100NF_6.3V_10%_X5R; CAPC0603X33N; Voltage 6.3V; Tolerance ±10%; Part Number CC0201_100NF_6.3V_10%_X5R
R39, R40, R41: R0402_2K2_1%_0.0625W_100PPM; RESC1005X40N; Tolerance ±1%; Part Number R0402_2K2_1%_0.0625W_100PPM
R42, R43, R44, R274: R0402_0R_JUMPER; RESC1005X40N; Part Number R0402_0R_JUMPER
R45, R46, R47, R48, R49, R50, R51, R52, R53, R54, R55, R56, R57, R75, R83, R91: R0402_22K_1%_0.0625W_100PPM; RESC1005X40N; Tolerance ±1%; Part Number R0402_22K_1%_0.0625W_100PPM
U5: TCA9548ARGER; QFN50P400X400X100-25N-S220; Manufacturer Part Number TCA9548ARGER

Notes on the sheet:
FMC1
FMC2
SFP1
SFP2
SFP3
SFP4
