BerkeleyLab/Marble-Mini/JTAG.sch

## KiCad design JTAG.sch (2020-09-25)

Schematic: JTAG.sch

Parts:
C193, C211, C212, C213, C214, C358, C359: CC0201_100NF_6.3V_10%_X5R; CAPC0603X33N; Voltage 6.3V; Tolerance ±10%; Part Number CC0201_100NF_6.3V_10%_X5R
D14, D15, D17, D18: BAT165; SOD2512X110N; Voltage 40V; Part Number BAT165
J11: MOLEX_87831-1420; Part Number MOLEX_87831-1420
J14: FTSH-105-01-L-DV-K; SAMTEC_FTSH-105-01-L-DV-K; Manufacturer Part Number FTSH-105-01-L-DV-K
Q5, Q17: BSS138LT1G; SOT95P240X110-3N; Part Number BSS138LT1G
R63, R131, R166, R246, R276: R0402_10K_1%_0.0625W_100PPM; RESC1005X40N; Tolerance ±1%; Part Number R0402_10K_1%_0.0625W_100PPM
R215, R216, R228, R229, R230, R231, R232, R233, R237, R238, R239, R240, R241, R242, R275, R277, R278, R279, R280, R289, R290: R0402_0R_JUMPER; RESC1005X40N; Part Number R0402_0R_JUMPER
U7, U10: NC7SZ66P5X; SOT65P210X110-5N; Part Number NC7SZ66P5X
U8, U9: SN74AVC2T245RSWR; QFN40P140X180X55-10N; Part Number SN74AVC2T245RSWR

Notes on the sheet:
output
input
