BerkeleyLab/Marble-Mini/MMC.sch

## KiCad design MMC.sch (2020-09-25)

Schematic: MMC.sch

Parts:
C92: CC0402_150PF_50V_5%_C0G; CAPC1005X55N; Voltage 50V; Tolerance ±5%; Part Number CC0402_150PF_50V_5%_C0G
C93: CC0402_22PF_50V_5%_C0G; CAPC1005X55N; Voltage 50V; Tolerance ±5%; Part Number CC0402_22PF_50V_5%_C0G
C102: CC0402_100PF_50V_5%_C0G; CAPC1005X55N; Voltage 50V; Tolerance ±5%; Part Number CC0402_100PF_50V_5%_C0G
C197, C198, C199, C200, C201, C202, C203, C204, C205, C206, C207, C208, C209: CC0201_100NF_6.3V_10%_X5R; CAPC0603X33N; Voltage 6.3V; Tolerance ±10%; Part Number CC0201_100NF_6.3V_10%_X5R
D3: BAT165; SOD2512X110N; Voltage 40V; Part Number BAT165
L9: IND0603_MURATA_BLM18SG121TN1D; INDC1608X65N; Tolerance ±25%; Part Number IND0603_MURATA_BLM18SG121TN1D
LD13, LD14: LED_AVAGO_HSMC-C120; Part Number LED_AVAGO_HSMC-C120
LD15: LED_KINGBRIGHT_KPH-1608CGCK; Part Number LED_KINGBRIGHT_KPH-1608CGCK
R132, R135, R136: R0402_0R_JUMPER; RESC1005X40N; Part Number R0402_0R_JUMPER
R133, R134, R309, R310: R0402_2K2_1%_0.0625W_100PPM; RESC1005X40N; Tolerance ±1%; Part Number R0402_2K2_1%_0.0625W_100PPM
R137, R138, R139, R140, R142, R143, R144, R145, R146, R147, R158, R263: R0402_10K_1%_0.0625W_100PPM; RESC1005X40N; Tolerance ±1%; Part Number R0402_10K_1%_0.0625W_100PPM
R148, R149, R150, R151, R152, R153, R154, R155: R0402_100R_1%_0.1W_100PPM; RESC1005X40N; Voltage 50V; Tolerance ±1%; Part Number R0402_100R_1%_0.1W_100PPM
R266, R267, R268: R0402_1K_1%_0.0625W_100PPM; RESC1005X40N; Tolerance ±1%; Part Number R0402_1K_1%_0.0625W_100PPM
SW2: SKHHLQA010; PB_ALPS_SKHHLQA010; Manufacturer Part Number SKHHLQA010
SW3: KSS241GLFS; Manufacturer Part Number KSS241GLFS
U2: LPC1776FET180,551; BGA180C80P14X14_1200X1200X120; Manufacturer Part Number LPC1776FET180,551
Y5: XTAL_8MHZ_TXC_7A-8.000MAAE-T; XTAL_TXC_7A; Part Number XTAL_8MHZ_TXC_7A-8.000MAAE-T

Notes on the sheet:
Clock source option
Pmod_SEL
Pmod_SCK
Pmod_MISO
Pmod_MOSI
UART4_RxD
UART4_TxD
EINT1
