BerkeleyLab/Marble-Mini/PMOD.sch

## KiCad design PMOD.sch (2020-09-25)

Schematic: PMOD.sch

Parts:
J12, J13, J16: PPTC062LJBN-RC; SDL-112-X-XX_2x06; Manufacturer Part Number PPTC062LJBN-RC
