BerkeleyLab/Marble-Mini/Power.sch

## KiCad design Power.sch (2020-09-25)

Schematic: Power.sch

Parts:
C128, C130, C131, C134, C135, C357: CC0402_100NF_25V_10%_X5R; CAPC1005X55N; Voltage 25V; Tolerance ±10%; Part Number CC0402_100NF_25V_10%_X5R
C129: CC0603_4.7UF_25V_10%_X5R; CAPC1709X95N; Voltage 25V; Tolerance ±10%; Part Number CC0603_4.7UF_25V_10%_X5R
C132: CC0603_22UF_6.3V_20%_X5R; CAPC1709X100N; Voltage 6.3V; Tolerance ±20%; Part Number CC0603_22UF_6.3V_20%_X5R
C133, C136, C351, C380: CC0201_100NF_6.3V_10%_X5R; CAPC0603X33N; Voltage 6.3V; Tolerance ±10%; Part Number CC0201_100NF_6.3V_10%_X5R
C350: CAE830-1020_470UF_16V_20%; CAPAE830X1020N; Voltage 16V; Tolerance ±20%; Part Number CAE830-1020_470UF_16V_20%
C353, C354: CPER_4.7NF_400V_5%_500-250X720X650; CAPR500-250X720X650; Voltage 400VDC/200VAC; Tolerance ±5%; Part Number CPER_4.7NF_400V_5%_500-250X720X650
D4, D12: SS16; DIOM5127X229N; Voltage 60V; Part Number SS16
D6, D7: MB210S-TP; SOIC254P665X290-4N; Manufacturer Part Number KMB210STR
D8: SMAJ58A; DIOM5226X262N; Manufacturer Part Number SMAJ58A-13-F
D9: BAT165; SOD2512X110N; Voltage 40V; Part Number BAT165
J1: CLIFF_FC68148(DC-10A); Part Number CLIFF_FC68148(DC-10A)
J17: TE_641119-2; 641119-2
L13: IND_10UH_20%_TDK_VLCF5020-1; IND_TDK_VLCF5020-1; Tolerance ±20%; Part Number IND_10UH_20%_TDK_VLCF5020-1
L35, L36, L37, L38, L39, L40: 1k@100MHz; INDC2012X145N; Manufacturer Part Number MPZ2012S102A
LD1, LD2: LED_KINGBRIGHT_KPH-1608CGCK; Part Number LED_KINGBRIGHT_KPH-1608CGCK
Q1, Q15, Q22: BC857BV; SOTFL50P160X60-6N; Part Number BC857BV
Q2, Q3, Q4, Q16, Q23: SI4425DDY-T1-GE3; SOIC127P600X175-8N; Part Number SI4425DDY-T1-GE3
Q8, Q9: BSS138LT1G; SOT95P240X110-3N; Part Number BSS138LT1G
Q25: Si2315BDS-T1-E3; SOT95P237X112-3N; Part Number Si2315BDS-T1-E3
R104, R180, R181: R0402_47K_1%_0.0625W_100PPM; RESC1005X40N; Tolerance ±1%; Part Number R0402_47K_1%_0.0625W_100PPM
R107, R179, R184: R0402_1K_1%_0.0625W_100PPM; RESC1005X40N; Tolerance ±1%; Part Number R0402_1K_1%_0.0625W_100PPM
R108, R110, R212: R0402_82K_1%_0.0625W_100PPM; RESC1005X40N; Tolerance ±1%; Part Number R0402_82K_1%_0.0625W_100PPM
R109: R0402_270K_1%_0.0625W_100PPM; RESC1005X40N; Tolerance ±1%; Part Number R0402_270K_1%_0.0625W_100PPM
R111: R1206_0R47_1%_0.5W_600PPM; RESC3216X65N; Tolerance ±1%; Part Number R1206_0R47_1%_0.5W_600PPM
R170, R171, R188, R201, R202, R203, R213, R214, R235, R236: R0402_10K_1%_0.0625W_100PPM; RESC1005X40N; Tolerance ±1%; Part Number R0402_10K_1%_0.0625W_100PPM
R182, R183, R301, R302, R303: R1206_0R082_1%_0.5W_100PPM; RESC3216X80N; Tolerance ±1%; Part Number R1206_0R082_1%_0.5W_100PPM
R197, R198, R281: R0402_0R_JUMPER; RESC1005X40N; Part Number R0402_0R_JUMPER
TP1, TP2, TP10: TestPoint; TestPoint_Pad_D1.0mm
U17, U32, U43: INA219BIDCNT; SOT65P280X145-8N; Part Number INA219BIDCNT
U18: TPS62175DQC; SON50P200X300X80-11N-R94X250; Part Number TPS62175DQC
U40: AG5300; Manufacturer Part Number AG5300
U41: FOD817DSD; FAIRCHILD_FOD817DSD; Part Number FOD817DSD

Notes on the sheet:
EMI Filter
+12V can be supplied by any one of: * barrel jack * AMC connector * POE module
<---
--->
0x84
0x80
0x82
MTA-156-2
