BerkeleyLab/Marble-Mini/Power_SW.sch

## KiCad design Power_SW.sch (2020-09-25)

Schematic: Power_SW.sch

Parts:
C105, C127, C139, C142, C143, C144, C159, C161, C195, C331, C347, C348, C349, C361: CC0603_4.7UF_25V_10%_X5R; CAPC1709X95N; Voltage 25V; Tolerance ±10%; Part Number CC0603_4.7UF_25V_10%_X5R
C137, C140, C147, C148, C149, C150, C362, C363: CC0402_100NF_25V_10%_X5R; CAPC1005X55N; Voltage 25V; Tolerance ±10%; Part Number CC0402_100NF_25V_10%_X5R
C138: CC0402_2.2NF_50V_10%_X7R; CAPC1005X55N; Voltage 50V; Tolerance ±10%; Part Number CC0402_2.2NF_50V_10%_X7R
C141, C151, C153, C155, C157: CC0805_22UF_25V_20%_X5R; CAPC2012X135N; Voltage 25V; Tolerance ±20%; Part Number CC0805_22UF_25V_20%_X5R
C145, C146: CC0603_22UF_6.3V_20%_X5R; CAPC1709X100N; Voltage 6.3V; Tolerance ±20%; Part Number CC0603_22UF_6.3V_20%_X5R
C152, C154, C156, C158, C160, C194, C330, C340, C341, C345, C346: CC0805_47UF_6.3V_20%_X5R; CAPC2012X140N; Voltage 6.3V; Tolerance ±20%; Part Number CC0805_47UF_6.3V_20%_X5R
D2, D5: BAT165; SOD2512X110N; Voltage 40V; Part Number BAT165
J9: 2057-PH1-04-UA-ND; SAMTEC_MTLW-104-07-L-S-250; Manufacturer Part Number PH1-04-UA
L14, L21, L22, L31, L32: IND1806_MURATA_BLM41PG600SN1L; INDC4516X180N; Part Number IND1806_MURATA_BLM41PG600SN1L
L15, L16, L33, L34: IND0603_MURATA_BLM18SG121TN1D; INDC1608X65N; Tolerance ±25%; Part Number IND0603_MURATA_BLM18SG121TN1D
L17, L18, L19, L20: IND_2.2UH_20%_BOURNS_SRP6540; IND_BOURNS_SRP6540; Tolerance ±20%; Part Number IND_2.2UH_20%_BOURNS_SRP6540
LD4, LD5, LD6, LD7, LD8, LD9, LD10: LED_KINGBRIGHT_KPH-1608CGCK; Part Number LED_KINGBRIGHT_KPH-1608CGCK
Q10, Q11, Q12, Q13: FDMS7608S; FAIRCHILD_MLP08P; Part Number FDMS7608S
Q26, Q27: BC847BV; SOTFL50P160X60-6N; Part Number BC847BV
R157, R167, R247, R249, R250, R252, R253, R254, R255, R256, R257: R0402_10K_1%_0.0625W_100PPM; RESC1005X40N; Tolerance ±1%; Part Number R0402_10K_1%_0.0625W_100PPM
R168, R189, R190, R191, R192, R193, R194, R195, R196: R0402_0R_JUMPER; RESC1005X40N; Part Number R0402_0R_JUMPER
R245, R248, R251: R0402_1K_1%_0.0625W_100PPM; RESC1005X40N; Tolerance ±1%; Part Number R0402_1K_1%_0.0625W_100PPM
TP3, TP4, TP5, TP6, TP7, TP8: TestPoint; TestPoint_Pad_D1.0mm
U35: XRP7724ILB-F; QFN50P700X700X80-45N-S520; Part Number XRP7724ILB-F
U36: NCP186AMX180TAG; SOIC-8; Manufacturer Part Number NCP186AMX180TAG
U37: NCP186AMX120TAG; SOIC-8; Manufacturer Part Number NCP186AMX120TAG

Notes on the sheet:
External clock input
1V2
D5 for programming supply path I2C_PM is forced to ground without +3V3P
55uF LOAD on FPGA sheet
350uF LOAD on FPGA sheet
140uF LOAD on FPGA sheet
90uF LOAD on FPGA sheet
RDSon 7.2 mOhms
