BerkeleyLab/Marble-Mini/SDRAM.sch

## KiCad design SDRAM.sch (2020-09-25)

Schematic: SDRAM.sch

Parts:
C14, C15, C16, C17, C18, C19, C20, C21, C23, C25, C365, C366, C367, C368, C369, C370, C371, C372: CC0201_100NF_6.3V_10%_X5R; CAPC0603X33N; Voltage 6.3V; Tolerance ±10%; Part Number CC0201_100NF_6.3V_10%_X5R
C22, C26, C27: CC0603_22UF_6.3V_20%_X5R; CAPC1709X100N; Voltage 6.3V; Tolerance ±20%; Part Number CC0603_22UF_6.3V_20%_X5R
C24: CC0402_1UF_16V_10%_X5R; CAPC1005X55N; Voltage 16V; Tolerance ±10%; Part Number CC0402_1UF_16V_10%_X5R
C364, C373: CC0603_4.7UF_25V_10%_X5R; CAPC1709X95N; Voltage 25V; Tolerance ±10%; Part Number CC0603_4.7UF_25V_10%_X5R
R1, R2, R3: R0402_51R_1%_0.0625W_100PPM; RESC1005X40N; Tolerance ±1%; Part Number R0402_51R_1%_0.0625W_100PPM
R4, R5, R6, R7, R8, R9, R10, R11, R12, R13, R14, R15, R16, R17, R18, R19, R20, R21, R22, R23, R27, R106: R0402_40R2_1%_0.0625W_100PPM; RESC1005X40N; Tolerance ±1%; Part Number R0402_40R2_1%_0.0625W_100PPM
R24, R25, R26: R0402_5K1_1%_0.0625W_100PPM; RESC1005X40N; Tolerance ±1%; Part Number R0402_5K1_1%_0.0625W_100PPM
R28: R0402_240R_1%_0.0625W_100PPM; RESC1005X40N; Tolerance ±1%; Part Number R0402_240R_1%_0.0625W_100PPM
R29, R30, R31: R0402_10K_1%_0.0625W_100PPM; RESC1005X40N; Tolerance ±1%; Part Number R0402_10K_1%_0.0625W_100PPM
TP9: TestPoint; TestPoint_Pad_D1.0mm
U3: MT41K512M16HA-125_E; BGA96C80P9X16_900X1400X120; Part Number MT41K512M16HA-125:E
U31: TPS51200DRC; TEXAS_DRC(S-PVSON-N10); Manufacturer Part Number TPS51200DRC

Notes on the sheet:
pin 4 and 11 are connected to pin 8
No need to control CS pin,
