BerkeleyLab/Marble-Mini/SFP1.sch

## KiCad design SFP1.sch (2020-09-25)

Schematic: SFP1.sch

Parts:
C28, C32, C34, C35: CC0201_100NF_6.3V_10%_X5R; CAPC0603X33N; Voltage 6.3V; Tolerance ±10%; Part Number CC0201_100NF_6.3V_10%_X5R
C29, C31: CC0402_1UF_16V_10%_X5R; CAPC1005X55N; Voltage 16V; Tolerance ±10%; Part Number CC0402_1UF_16V_10%_X5R
C30, C33: CC0603_10UF_6.3V_20%_X5R; CAPC1608X87N; Voltage 6.3V; Tolerance ±20%; Part Number CC0603_10UF_6.3V_20%_X5R
Cage1: TYCO_2007132-1; Part Number TYCO_2007132-1
J3: TYCO_1888247-1; TE_1888247-1; Part Number TYCO_1888247-1
L1, L2: IND0603_MURATA_BLM18SG121TN1D; INDC1608X65N; Tolerance ±25%; Part Number IND0603_MURATA_BLM18SG121TN1D
R32, R34, R35, R36, R37, R38: R0402_10K_1%_0.0625W_100PPM; RESC1005X40N; Tolerance ±1%; Part Number R0402_10K_1%_0.0625W_100PPM
R33, R105: R0402_0R_JUMPER; RESC1005X40N; Part Number R0402_0R_JUMPER
