BerkeleyLab/Marble-Mini/SFP2.sch

## KiCad design SFP2.sch (2020-09-25)

Schematic: SFP2.sch

Parts:
C70, C74, C76, C77: CC0201_100NF_6.3V_10%_X5R; CAPC0603X33N; Voltage 6.3V; Tolerance ±10%; Part Number CC0201_100NF_6.3V_10%_X5R
C71, C73: CC0402_1UF_16V_10%_X5R; CAPC1005X55N; Voltage 16V; Tolerance ±10%; Part Number CC0402_1UF_16V_10%_X5R
C72, C75: CC0603_10UF_6.3V_20%_X5R; CAPC1608X87N; Voltage 6.3V; Tolerance ±20%; Part Number CC0603_10UF_6.3V_20%_X5R
J6: TYCO_1888247-1; TE_1888247-1; Part Number TYCO_1888247-1
L41, L42: IND0603_MURATA_BLM18SG121TN1D; INDC1608X65N; Tolerance ±25%; Part Number IND0603_MURATA_BLM18SG121TN1D
R68, R70, R71, R72, R73, R74: R0402_10K_1%_0.0625W_100PPM; RESC1005X40N; Tolerance ±1%; Part Number R0402_10K_1%_0.0625W_100PPM
R69, R185: R0402_0R_JUMPER; RESC1005X40N; Part Number R0402_0R_JUMPER
