BerkeleyLab/Marble-Mini/SFP4.sch

## KiCad design SFP4.sch (2020-09-25)

Schematic: SFP4.sch

Parts:
C94, C98, C100, C101: CC0201_100NF_6.3V_10%_X5R; CAPC0603X33N; Voltage 6.3V; Tolerance ±10%; Part Number CC0201_100NF_6.3V_10%_X5R
C95, C97: CC0402_1UF_16V_10%_X5R; CAPC1005X55N; Voltage 16V; Tolerance ±10%; Part Number CC0402_1UF_16V_10%_X5R
C96, C99: CC0603_10UF_6.3V_20%_X5R; CAPC1608X87N; Voltage 6.3V; Tolerance ±20%; Part Number CC0603_10UF_6.3V_20%_X5R
J8: TYCO_1888247-1; TE_1888247-1; Part Number TYCO_1888247-1
L7, L8: IND0603_MURATA_BLM18SG121TN1D; INDC1608X65N; Tolerance ±25%; Part Number IND0603_MURATA_BLM18SG121TN1D
R85, R87, R88, R89, R90, R186: R0402_10K_1%_0.0625W_100PPM; RESC1005X40N; Tolerance ±1%; Part Number R0402_10K_1%_0.0625W_100PPM
R86, R187: R0402_0R_JUMPER; RESC1005X40N; Part Number R0402_0R_JUMPER
