BerkeleyLab/Marble-Mini/Thermometers.sch

## KiCad design Thermometers.sch (2020-09-25)

Schematic: Thermometers.sch

Parts:
C188, C189: CC0402_10NF_35V_10%_X7R; CAPC1005X55N; Voltage 35V; Tolerance ±10%; Part Number CC0402_10NF_35V_10%_X7R
C190, C191, C192: CC0201_100NF_6.3V_10%_X5R; CAPC0603X33N; Voltage 6.3V; Tolerance ±10%; Part Number CC0201_100NF_6.3V_10%_X5R
C343, C344: CC0603_4.7UF_25V_10%_X5R; CAPC1709X95N; Voltage 25V; Tolerance ±10%; Part Number CC0603_4.7UF_25V_10%_X5R
M1, M2: Fan_3pin; Fan_Pin_Header_Straight_1x03; Manufacturer Part Number SWR25X-NRTC-S03-ST-BA
Q7: STS8DN6LF6AG; SOIC127P600X175-8N; Manufacturer Part Number STS8DN6LF6AG
R129: R0402_0R_JUMPER; RESC1005X40N; Part Number R0402_0R_JUMPER
R130, R172, R173, R174, R175, R176, R177, R178: R0402_10K_1%_0.0625W_100PPM; RESC1005X40N; Tolerance ±1%; Part Number R0402_10K_1%_0.0625W_100PPM
U27: MAX6639AEE+; SOP63P600X175-16N; Part Number MAX6639AEE+
U28, U29: LM75AIMM/NOPB; SOP65P490X109-8N; Manufacturer Part Number LM75AIMM/NOPB

Notes on the sheet:
Nestled in with XRP7724 and its power transistors
Near front panel under FMC1
