BerkeleyLab/Marble-Mini/USB.sch

## KiCad design USB.sch (2020-09-25)

Schematic: USB.sch

Parts:
C162, C167, C168, C173, C360: CC0603_4.7UF_25V_10%_X5R; CAPC1709X95N; Voltage 25V; Tolerance ±10%; Part Number CC0603_4.7UF_25V_10%_X5R
C163, C164, C166, C169, C170, C174, C175, C176, C177, C178, C179, C180, C181, C182, C183, C184, C185, C186, C187, C355, C356: CC0201_100NF_6.3V_10%_X5R; CAPC0603X33N; Voltage 6.3V; Tolerance ±10%; Part Number CC0201_100NF_6.3V_10%_X5R
C165, C171: CC0402_22PF_50V_5%_C0G; CAPC1005X55N; Voltage 50V; Tolerance ±5%; Part Number CC0402_22PF_50V_5%_C0G
C172: CC0603_22UF_6.3V_20%_X5R; CAPC1709X100N; Voltage 6.3V; Tolerance ±20%; Part Number CC0603_22UF_6.3V_20%_X5R
D13: PRTR5V0U2X; SOT190P230X110-4N; Voltage 5.5V; Part Number PRTR5V0U2X
D16: BAT165; SOD2512X110N; Voltage 40V; Part Number BAT165
J10: 10103594-0001LF; USB_Micro-B_Amphenol_10103594-0001LF_Horizontal; Part Number 10103594-0001LF
L10, L24, L25: IND0603_MURATA_BLM18SG121TN1D; INDC1608X65N; Tolerance ±25%; Part Number IND0603_MURATA_BLM18SG121TN1D
L23: IND_2.2UH_20%_WURTH_WE-PMCI_74479276222C; IND_WURTH_WE-PMCI_0806LR; Tolerance ±20%; Part Number IND_2.2UH_20%_WURTH_WE-PMCI_74479276222C
Q6, Q14, Q18, Q24: BSS138LT1G; SOT95P240X110-3N; Part Number BSS138LT1G
R112, R114, R119: R0402_2K2_1%_0.0625W_100PPM; RESC1005X40N; Tolerance ±1%; Part Number R0402_2K2_1%_0.0625W_100PPM
R113, R115, R116, R117, R118, R121, R122, R123, R124, R125, R126, R127, R204, R270, R271, R272: R0402_10K_1%_0.0625W_100PPM; RESC1005X40N; Tolerance ±1%; Part Number R0402_10K_1%_0.0625W_100PPM
R120: R0402_12K_1%_0.0625W_100PPM; RESC1005X40N; Tolerance ±1%; Part Number R0402_12K_1%_0.0625W_100PPM
R128, R273: R0402_47K_1%_0.0625W_100PPM; RESC1005X40N; Tolerance ±1%; Part Number R0402_47K_1%_0.0625W_100PPM
R200: R0402_0R_JUMPER; RESC1005X40N; Part Number R0402_0R_JUMPER
R269: R0402_82K_1%_0.0625W_100PPM; RESC1005X40N; Tolerance ±1%; Part Number R0402_82K_1%_0.0625W_100PPM
TP11: TestPoint; TestPoint_Pad_D1.0mm
U15, U24, U25, U26, U33, U38: SN74AVC2T245RSWR; QFN40P140X180X55-10N; Part Number SN74AVC2T245RSWR
U21: 93LC56B-I/SN; SOIC127P600X175-8N; Part Number 93LC56B-I/SN
U22: TLV62565DBVT; SOT95P280X145-5N; Part Number TLV62565DBVT
U23: FT4232H-56Q; QFN50P800X800X100-57N-S620; Part Number FT4232H-56Q
Y4: XTAL_12MHZ_TXC_7M-12.000MAAJ-T; XTAL_TXC_7M; Part Number XTAL_12MHZ_TXC_7M-12.000MAAJ-T

Notes on the sheet:
TxD OUT
RxD IN
RTS OUT
DTR OUT
USB_TCK
USB_TDI_DO
USB_TDO_DI
USB_TMS
