BerkeleyLab/Marble-Mini/WhiteRabbit.sch

## KiCad design WhiteRabbit.sch (2020-09-25)

Schematic: WhiteRabbit.sch

Parts:
C36, C81, C123, C383: CC0402_1UF_16V_10%_X5R; CAPC1005X55N; Voltage 16V; Tolerance ±10%; Part Number CC0402_1UF_16V_10%_X5R
C80, C90, C91, C108, C109, C110, C112, C115, C116, C117, C122, C124, C125, C126, C196, C210, C384: CC0201_100NF_6.3V_10%_X5R; CAPC0603X33N; Voltage 6.3V; Tolerance ±10%; Part Number CC0201_100NF_6.3V_10%_X5R
C106, C111, C113, C118, C119, C120, C121: CC0603_22UF_6.3V_20%_X5R; CAPC1709X100N; Voltage 6.3V; Tolerance ±20%; Part Number CC0603_22UF_6.3V_20%_X5R
C107: CC0402_10NF_35V_10%_X7R; CAPC1005X55N; Voltage 35V; Tolerance ±10%; Part Number CC0402_10NF_35V_10%_X7R
C114: CC0402_2.2NF_50V_10%_X7R; CAPC1005X55N; Voltage 50V; Tolerance ±10%; Part Number CC0402_2.2NF_50V_10%_X7R
C389: CC0402_100NF_25V_10%_X5R; CAPC1005X55N; Voltage 25V; Tolerance ±10%; Part Number CC0402_100NF_25V_10%_X5R
L11, L12, L26: IND0603_MURATA_BLM18SG121TN1D; INDC1608X65N; Tolerance ±25%; Part Number IND0603_MURATA_BLM18SG121TN1D
R58, R92, R93: R0402_240R_1%_0.0625W_100PPM; RESC1005X40N; Tolerance ±1%; Part Number R0402_240R_1%_0.0625W_100PPM
R94, R96, R97, R98, R99, R100, R101, R102: R0402_0R_JUMPER; RESC1005X40N; Part Number R0402_0R_JUMPER
R95: R0402_40R2_1%_0.0625W_100PPM; RESC1005X40N; Tolerance ±1%; Part Number R0402_40R2_1%_0.0625W_100PPM
R103: R0402_100R_1%_0.1W_100PPM; RESC1005X40N; Voltage 50V; Tolerance ±1%; Part Number R0402_100R_1%_0.1W_100PPM
R308: R0402_10K_1%_0.0625W_100PPM; RESC1005X40N; Tolerance ±1%; Part Number R0402_10K_1%_0.0625W_100PPM
U13: LP5951MF-3.0/NOPB; SOT95P284X122-5N; Manufacturer Part Number LP5951MF-3.0/NOPB
U14: LM336M-2.5; SOIC127P600X175-8N; Manufacturer Part Number LM336M-2.5
U16, U19: AD5662BRMZ-1; SOP65P490X110-8N; Part Number AD5662BRMZ-1
U20: CDCM61004RHBT; QFN50P500X500X100-33N-S355; Part Number CDCM61004RHBT
Y1: OSC_25MHZ_RAKON_IVT3205CR; OSC_ABRACON_ASEMPC; Part Number OSC_25MHZ_RAKON_IVT3205CR
Y2: VM53S3-25.000-2.5/-30+75; OSCCC320X500X160-4N; Manufacturer Part Number VM53S3-25.000-2.5/-30+75
Y3: OSC_20MHZ_IQD_LFVCXO026156; OSC_IQD_CFPV-45; Part Number OSC_20MHZ_IQD_LFVCXO026156
Y6: OSC_10-280MHZ_SILICON-LAB_Si570BBC000121DG; OSC_SILICON-LAB_SI570; Part Number OSC_10-280MHZ_SILICON-LAB_Si570BBC00012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

Notes on the sheet:
PRESC DIV = 4 FB DIV = 20 OUT DIV = 4 Input = 25 MHz Output=125 MHz
LVPECL, OSC_OUT On: OS1 = 1 OS0 = 1
All config inputs have internal pull-ups.
Note: KiCad throws an ERC error here, "Conflict problem between pins", arising from both Y1 and Y2 driving the output. KiCad's eeschem doesn't understand the KiBoM semantics of the config: dnf attribute on Y2.
