BerkeleyLab/Marble-Mini/(commit log)

2019-03-16 v1.0rc1
    schematics and component placement ready for review.
    [AMC_Connector_k.sch, AMC_FMC_Carrier-PcbDoc.sch, AMC_connector.sch, ETH_PHY.sch, FMC_1.sch, FMC_2.sch, FPGA.sch, FPGA_13_14.sch]
2019-03-21 Add files via upload
    ddr tune, new exar chip, power supply
    [AMC_FMC_Carrier-PcbDoc.csv, AMC_FMC_Carrier-PcbDoc.sch, ETH_PHY.sch, FMC_2.sch, FPGA_15_16.sch, JTAG.sch, Power.sch, Power_SW.sch]
2019-03-22 powel planes, other signals
    [Power_SW.sch]
2019-03-25 marble_i2c.eps: new documentation on I2C bus
2019-03-26 LEDs and button added, routed other signals
    [AMC_FMC_Carrier-PcbDoc.sch, AMC_connector.sch, ETH_PHY.sch, FMC_1.sch, FMC_2.sch, FPGA.sch, FPGA_15_16.sch, FPGA_PWR&MISC.sch]
2019-03-27 routing finished
    [AMC_FMC_Carrier-PcbDoc.sch, AMC_connector.sch, FPGA_13_14.sch, JTAG.sch, MMC.sch, USB.sch]
2019-04-02 bugs fixed
    [AMC_FMC_Carrier-PcbDoc.sch, FMC_1.sch, FMC_2.sch, FPGA.sch, FPGA_13_14.sch, FPGA_15_16.sch, FPGA_34_35.sch, I2C_MUX.sch]
2019-04-03 HDMI footprint changed, silk layer edited, bugs fixed
    [AMC_connector.sch, ETH_PHY.sch, FPGA_MGT.sch, I2C_MUX.sch, Power.sch, Power_SW.sch]
2019-04-03 Remove stale AMC_FMC_Carrier-PcbDoc.pdf
2019-04-08 some DRC errors fixed
    [AMC_FMC_Carrier-PcbDoc.sch, Power_SW.sch]
2019-04-15 cosmetic corrections
    [AMC_FMC_Carrier-PcbDoc.sch, AMC_connector.sch, ETH_PHY.sch, FMC_1.sch, FMC_2.sch, FPGA.sch, FPGA_13_14.sch, FPGA_15_16.sch]
2019-04-19 bugs fixed, silkscreen edited
    [AMC_FMC_Carrier-PcbDoc.sch, AMC_connector.sch, ETH_PHY.sch, FMC_1.sch, FMC_2.sch, FPGA_13_14.sch, FPGA_15_16.sch, FPGA_34_35.sch]
2019-04-26 new FMC JTAG chain
    [AMC_FMC_Carrier-PcbDoc.sch, AMC_connector.sch, FMC_1.sch, FMC_2.sch, FPGA.sch, FPGA_13_14.sch, FPGA_15_16.sch, FPGA_34_35.sch]
2019-04-29 JTAG improvrmrnt, bugs fixed
    [AMC_FMC_Carrier-PcbDoc.sch, AMC_connector.sch, ETH_PHY.sch, FMC_1.sch, FMC_2.sch, FPGA.sch, FPGA_13_14.sch, FPGA_15_16.sch]
2019-05-02 ERC bugs fixed
    [AMC_FMC_Carrier-PcbDoc.sch, ETH_PHY.sch, FMC_1.sch, FMC_2.sch, I2C_MUX.sch, JTAG.sch, MMC.sch, PMOD.sch]
2019-05-07 bugs fixed, PB added
    [AMC_FMC_Carrier-PcbDoc.sch, FMC_1.sch, FMC_2.sch, I2C_MUX.sch, MMC.sch]
2019-05-09 diff pairs improved
    [AMC_FMC_Carrier-PcbDoc.sch, AMC_FMC_Carrier-PcbDoc_bom_9.csv, AMC_connector.sch, BOM.xlsx, ETH_PHY.sch, FMC_1.sch, FMC_2.sch, FPGA.sch]
2019-05-10 DDR terminations changed, HTML BoM with variant added
    [AMC_FMC_Carrier-PcbDoc.sch, AMC_connector.sch, ETH_PHY.sch, FMC_1.sch, FMC_2.sch, FPGA.sch, FPGA_13_14.sch, FPGA_15_16.sch]
2019-05-10 marble_i2c.eps:
    Fix (we hope) XRP7724 address
    Add note about I2C address convention
2019-05-15 Add board preview and embed in README
2019-05-15 SW2 placement changed, BOM cleared, FPGA boot, less ERC errors and wornings
    [ETH_PHY.sch, FMC_1.sch, FMC_2.sch, FPGA_13_14.sch, FPGA_PWR&MISC.sch, I2C_MUX.sch, JTAG.sch, MMC.sch]
2019-05-15 SW2 placement changed, BOM cleared, FPGA boot, less ERC errors and wornings, new board render
2019-05-15 romoved unnecessary files
    [AMC_FMC_Carrier-PcbDoc.csv, BOM.xlsx]
2019-05-17 BOM updated, 25MHz clock level fixed
    [AMC_connector.sch, ETH_PHY.sch, FMC_1.sch, FMC_2.sch, FPGA_13_14.sch, FPGA_15_16.sch, FPGA_34_35.sch, FPGA_MGT.sch]
2019-05-27 less traces under SFP cage, MLVDS transceiver added, TCLKA connected to FPGA
    [AMC_FMC_Carrier-PcbDoc.sch, AMC_connector.sch, ETH_PHY.sch, FPGA.sch, FPGA_15_16.sch, MMC.sch]
2019-05-28 QR code added, WR-CLK fixed
    [FPGA_15_16.sch]
2019-05-30 new FMC JTAG chain connected to MMC GPIO
    [AMC_FMC_Carrier-PcbDoc.sch, FMC_1.sch, JTAG.sch, MMC.sch, WhiteRabbit.sch]
2019-05-31 one more Ferrit at 1V has beed added
    [Power_SW.sch]
2019-06-03 U.FL for clock, logos moved, MII -> RGMII, new symbol library, git tag added
    [AMC_FMC_Carrier-PcbDoc.sch, ETH_PHY.sch, FPGA.sch, FPGA_13_14.sch, FPGA_15_16.sch, FPGA_34_35.sch, FPGA_MGT.sch, FPGA_PWR&MISC.sch]
2019-06-12 RGMII lines tuned, RGMII RX resistors added, MII->RGMII
    [AMC_FMC_Carrier-PcbDoc.sch, ETH_PHY.sch, FPGA_15_16.sch, SDRAM.sch]
2019-06-14 Silkscreen changes; Update logos and text
2019-06-18 No DRC errors
    [FPGA_15_16.sch]
2019-06-26 more designators are visible
    [FMC_1.sch, FPGA.sch, FPGA_MGT.sch, I2C_MUX.sch, JTAG.sch, Power.sch, Power_SW.sch, Thermometers.sch]
2019-07-05 P1 and P2 mounted as a SMT
2019-07-10 silkscreen back: update lbl and marble logo
2019-07-11 Start on instructions for manufacturing
    README_fab.txt
    manufacturing.sh is documentation and helper script for
    creating a zip file for turnkey manufacturing
    [AMC_FMC_Carrier-PcbDoc_bom_9.csv]
2019-07-15 Weight updated in stackup file
    [_saved_AMC_FMC_Carrier-PcbDoc.sch]
2019-08-05 BOM configuration file edited, updated Marble picture, some components part number changed
    [AMC_FMC_Carrier-PcbDoc.sch, AMC_connector.sch, ETH_PHY.sch, FPGA_13_14.sch, FPGA_15_16.sch, FPGA_34_35.sch, FPGA_MGT.sch, FPGA_PWR&MISC.sch]
2019-08-12 README edited, less ERC errors and warnings
    [AMC_FMC_Carrier-PcbDoc.sch, FPGA_15_16.sch, MMC.sch, Power.sch, Power_SW.sch, SDRAM.sch, SFP2.sch, SFP4.sch]
2019-08-12 BUG fixed: new DDR connections
    [FPGA_34_35.sch]
2019-08-19 added netlist to .xdc converter
    [Power_SW.sch]
2019-08-21 R221->DNP, netlist_to_xdc.py updated
    [FPGA_13_14.sch]
2019-11-13 applied all required amendments to the project
    [AMC_FMC_Carrier-PcbDoc.sch, AMC_connector.sch, ETH_PHY.sch, FMC_1.sch, FMC_2.sch, FPGA.sch, FPGA_13_14.sch, FPGA_15_16.sch]
2020-01-31 README.md: describe board configuration options
2020-01-31 Split AMC_FMC_Carrier-PcbDoc-cache.lib into actual libs
    Remove AMC_FMC_Carrier-PcbDoc-cache.lib and some other stray files
    Used dissect_lib.py
    Still have a bunch of rescued names that need cleanup
2020-02-01 Rename library AMC_FMC_Carrier-PcbDoc-rescue as marble_misc
    [AMC_FMC_Carrier-PcbDoc.sch, AMC_connector.sch, ETH_PHY.sch, FMC_1.sch, FMC_2.sch, FPGA_13_14.sch, FPGA_15_16.sch, FPGA_34_35.sch]
2020-02-01 Strip extraneous AMC_FMC_Carrier-PcbDoc-rescue and powerMG from symbol names
    [AMC_connector.sch, ETH_PHY.sch, FMC_1.sch, FMC_2.sch, FPGA_13_14.sch, FPGA_15_16.sch, FPGA_34_35.sch, FPGA_MGT.sch]
2020-02-03 spring cleaning
    removed some unused / unneeded files
    .lib = unused footprint libraries
    .dcm = empty files
    .xml = export to Altium project?
    .liblib = unused footprint libraries
2020-05-02 Add footprint library Marble.pretty, which also includes the logos
2020-05-04 PCB: fix mounting hole footprints
    removed and re-placed the 8 FMC mounting holes, the mechanical hole
    and the slot on the top left.
    Introduced a new footprint with a single pad at (0, 0)
    for each hole type.
    The original footprints contained a pad at non-zero
    (and different for each footprint) coordinates.
2020-05-04 Pads.lib: new mounting hole symbols
    introduce schematic symbols matching the new
    mounting hole footprints on the PCB
2020-05-04 schematic: add `branch: fab2` label
    tiny change to schematic results in a huge diff :p
    This will be my working version now.
    [AMC_FMC_Carrier-PcbDoc.sch, AMC_connector.sch, ETH_PHY.sch, FMC_1.sch, FMC_2.sch, FPGA.sch, FPGA_13_14.sch, FPGA_15_16.sch]
2020-05-04 SCH: add mounting hole B1 - B10
    [AMC_FMC_Carrier-PcbDoc.sch, JTAG.sch]
2020-05-04 Symbols lib. and schematic: update footprint fields
    sync with layout is now possible without errors
    [AMC_connector.sch, FPGA_15_16.sch, Power.sch, SDRAM.sch]
2020-05-04 footprint: change B9 pad 9 to B9 pad 1 to match symbol
2020-05-04 PCB: Update PCB from Schematic
    * `Re-associate footprints by reference` to
    match up the new mounting hole footprints with their
    new schematic symbols
    * this removed the footprint library name from the
    components on the PCB (see log excerpt below).
    I'm 70 % sure that's a good thing ;)
    Change C5 footprint from "Capacitors SMD:CAPC1005X55N" to "CAPC1005X55N".
    Change U6 footprint from "ICs And Semiconductors SMD:SOP50P310X90-8N" to "SOP50P310X90-8N".
2020-05-04 PCB: run DRC and save. No changes
2020-05-05 PCB: fix 6 DRC errors, connect J11, pin 2 to 2V5
    ... except for J11, copper didn't change.
2020-05-05 Increase silkscreen label size for user-facing components
    J4 J9 J10 J11 J12 J13 J14 J15 J16 S1 SW1 SW2 SW3 M1 M2
    change from 1mm to 2mm, also increase linewidth
2020-05-05 SCH: shave down ERC to 1 error, 0 warning
    * 1 unavoidable error due to the unpopulated crystal Y2
    * change many pin types in symbol libraries (also for FMC con.)
    * as a result, could remove some power flags
    * fix footrint attribute for SFP module symbols
    for most devices (not voltage regulators):
    * vcc = power input
    * gnd = power input
    * gpios (also FMC lanes) = bidirectional
    * configuration pins (tied to vcc / gnd) = inputs
    [FMC_1.sch, FMC_2.sch, SFP1.sch, SFP2.sch, SFP3.sch, SFP4.sch, USB.sch]
2020-05-05 Remove stray via, and disable zone fill
    Zone fill needs to be re-added (maybe as part of DRC) before exporting.
    Press "B" in the KiCad GUI.
    Layout file will be more "stable" for version control without the zone fills,
    and its size shrinks by more than a factor of two this way.
    Of course the diff for this commit is huge.
2020-05-07 Add SMD attribute to HDT0001 footprint and refresh it in PCB
2020-05-07 SCH: rename +3.3VP, 3V3PM and +3V3MP to +3V3P
    * all of them refer to the same net
    * to make confusion perfect, all 3 power symbols on the schematic
    were an instance of the symbol `+3.3VP` with different
    value attributes
    * renamed the `+3.3VP` symbol to `+3V3P` for naming consistency
    * SCH: replaced all power symbols on the net by the new one
    * PCB: still needs to be synced up, as the net name has changed
    [AMC_connector.sch, FMC_1.sch, FMC_2.sch, JTAG.sch, MMC.sch, Power.sch, Power_SW.sch, Thermometers.sch]
2020-05-07 PCB: rename net +3.3VP to +3V3P
    * confirmed that it's synced up with the schematic
    * confirmed DRC: 0 errors, 0 warnings
2020-05-07 Add 300 Ohm series resistors to GA pins
    [FMC_1.sch, FMC_2.sch]
2020-05-07 tie U4 (88E1512 Ethernet PHY): VDDO_SEL (10) low for VDDO = 2.5V
    [ETH_PHY.sch]
2020-05-07 Bigger/better silkscreen labeling of LD11 and LD12
2020-05-11 Move Q2 perfect-diode circuit from front to back
    Q1 Q2 R104 R107 R108 C128
    This now matches the side of two other perfect diode circuits.
    The high-current link from J1 to Q2 is OK, could be improved.
    The link from Q2 to +12V is just a placeholder,
    since the whole +12V net will be modified soon.
    Layout-only change; passes DRC.
2020-05-11 Add a current-sense resistor to the +12V net
    New net +12VS is on the source-side, upstream of R301.
    Routing topology is mostly OK, but the +12V net still
    needs some work to handle the currents.
    [Power.sch]
2020-05-11 add test-point footprint
2020-05-11 sch: add note about 12V power sources
    [Power.sch]
2020-05-12 SCH: Add 3rd INA219, remove +12VS power symbol
    ... also add some notes about current flow
    [FPGA.sch, I2C_MUX.sch, Power.sch]
2020-05-12 SCH: PWR_FLAG cosmetics, update annotation
    [AMC_connector.sch, ETH_PHY.sch, I2C_MUX.sch, Power.sch]
2020-05-12 Sync PCB
    [Power.sch]
2020-05-12 marble_i2c.eps: update
    Add new power monitor U43 INA219 0x84
    Correct refdes of uC and FPGA
    Remove all page numbers; they were based on some long-gone printout
    Used newer verison of xcircuit, 3.9 rev73 instead of 3.8 rev78
2020-05-12 PCB: route +12VS net on B.CU and In5.CU
    ... the new INA219 (U43) is not connected yet
2020-05-12 PCB: route the new INA219
2020-05-12 Change R182 R183 R301 from 0.02 Ohm to 0.082 Ohm
    More work than it sounds.
    Ohmite KDV12DR082ET.
    Sets up INA219 for FMC to register 82 mV at FMC spec max 12P0V current of 1.0 Amp.
    Whole-board current monitor isn't right yet. Soon.
    [Power.sch]
2020-05-12 Turn R301 into a triple
    with R302 and R303, net sense resistor value 0.0273 Ohms.
    With the INA219 set to a full-scale of 80 mV, that will yield 2.93 Amps full-scale.
    Have the option to go up from there by a factor of two and still be safe.
    [Power.sch]
2020-05-13 PCB: fix diff trace on In2.Cu and F.Cu
    it shifted by accident in f1882e2bd
2020-05-13 cleanup the diff. tracea bit more
2020-05-13 Configure S1 as dnf for standalone builds
    [AMC_FMC_Carrier-PcbDoc.sch]
2020-05-13 Configure three Pmod connectors as dnf for AMC builds
    [PMOD.sch]
2020-05-13 Add six test points
    [Power.sch, Power_SW.sch]
2020-05-13 make testpoint trough-hole with lbls on both sides
2020-05-13 fix 12 V trace overlapping with FTG2 on F.Cu
2020-05-13 Add four more testpoints to power nets
    [AMC_connector.sch, Power.sch, Power_SW.sch, SDRAM.sch]
2020-05-14 change R297 - R300 to 240 Ohm
    [FMC_1.sch, FMC_2.sch]
2020-05-14 Modify test point footprint
    Add bottom courtyard
    Increase various diameters
2020-05-14 Fuss with drill sizes
    0.700 mm != 0.701 mm
2020-05-14 Add one more test point, on +3V3_USB
    [USB.sch]
2020-05-15 Convert all footprints to use Marble nickname
    Includes both .sch and .lib files
    Includes both bare footprint names and those with CERN-like nicknames
    [AMC_FMC_Carrier-PcbDoc.sch, AMC_connector.sch, ETH_PHY.sch, FMC_1.sch, FMC_2.sch, FPGA.sch, FPGA_13_14.sch, FPGA_15_16.sch]
2020-05-15 mark SFP TX_DIS pulldown resistors as 0 Ohm DNF
    R84 R105 R185 R187
    [SFP1.sch, SFP2.sch, SFP3.sch, SFP4.sch]
2020-05-15 Mark R84 R105 R185 R187 dnf in a way that KiBom understands
    [SFP1.sch, SFP2.sch, SFP3.sch, SFP4.sch]
2020-05-15 I2C pull-up resistors are truly 22k
    Refresh from library to discard bogus 2K2 part number
    R45 R46 R47 R48 R49 R50 R51 R52 R53 R54 R55 R56 R57 R75 R83 R91
    [I2C_MUX.sch]
2020-05-15 Clean up BSS138 instances in schematic
    Q5 Q6 Q8 Q9 Q14 Q17 Q18 Q19 Q20 Q21 Q24
    Fewer warnings from KiBoM
    [FPGA_15_16.sch, FPGA_PWR&MISC.sch, JTAG.sch, Power.sch, USB.sch]
2020-05-15 Configure Gerber export as wanted
    No need for instructions to change it each time
2020-05-15 Remove stale BOM file
    [Marble_BOM.csv]
2020-05-15 Get rid of most .DbLib suffixes in Library Name attributes
    Enough that KiBoM no longer complains about them
    [FMC_1.sch, FMC_2.sch, FPGA_15_16.sch, FPGA_PWR&MISC.sch, I2C_MUX.sch, JTAG.sch, Power.sch, SFP1.sch]
2020-05-16 Get rid of more useless inconsistencies in Comment attributes
    Makes for quieter KiBoM runs
    [FMC_1.sch, FMC_2.sch, Power.sch, SFP1.sch, SFP2.sch, SFP3.sch, SFP4.sch]
2020-05-16 manufacturing.sh: create .xml file for KiBoM with "Generate Bill of Materials"
2020-05-16 Add silkscreen ID for MGTREFCLK selection
2020-05-16 Fix Silkscreen labels for 1.8V and 1.2V indicator LEDs
    They were swapped
2020-05-16 Document location of LM75 thermometer chips
    [Thermometers.sch]
2020-05-16 Change C103 to a higher voltage part
    old CC0805_4.7UF_10V_10%_X5R
    new CC0603_4.7UF_16V_10%_X5R
    [FPGA_15_16.sch]
2020-05-18 added MIC2090-1
    [FMC_1.sch, FMC_2.sch]
2020-05-18 add field to mounting hole symbols
    [AMC_FMC_Carrier-PcbDoc.sch]
2020-05-20 Fix up R59 R60 R61 R169
    These 200R components had lots of 100R vestiges in their instances.
    Now they're fully 200R, and R0201_200R_1%_0.05W_200PPM is a real library member.
    [FPGA_MGT.sch]
2020-05-20 replaced J14 connector, TCA9517 added, Exar chip hex files added
    [FPGA_15_16.sch, I2C_MUX.sch, JTAG.sch]
2020-05-20 remove power flag at U44, U45 VOUT-pin
    [FMC_1.sch, FMC_2.sch]
2020-05-20 connect track to R304 pad
2020-05-20 Fix 3 DRC problems
    had to change the 3 footprints on the pcb to the
    ones from the Marble:... library
2020-05-20 Replace Val=DNP with actual value for 6 resistors
    [FPGA_PWR&MISC.sch, I2C_MUX.sch, Power.sch, Power_SW.sch]
2020-05-20 make DNF field visible for 6 resistors
    [FPGA_PWR&MISC.sch, I2C_MUX.sch, Power.sch, Power_SW.sch]
2020-05-20 Get rid of "~" attribute in instances
    This makes instances line up better with our library
    Use a very short python program to rename "~" to "Val" and remove the old "Val".
    Required a little pre-patch to correctly handle R297 R298 R299 R300 R162 R274 R197 R198, which had no "~" field.
    No net changes to "Val" field contents.
    [AMC_FMC_Carrier-PcbDoc.sch, ETH_PHY.sch, FMC_1.sch, FMC_2.sch, FPGA.sch, FPGA_13_14.sch, FPGA_15_16.sch, FPGA_MGT.sch]
2020-05-21 Remove some stale .sch files
    [AMC_Connector_k.sch, SFP.sch, projekt.sch]
2020-05-21 refresh schematic files with updated F sequence numbers
    [AMC_FMC_Carrier-PcbDoc.sch, ETH_PHY.sch, FMC_1.sch, FMC_2.sch, FPGA.sch, FPGA_13_14.sch, FPGA_15_16.sch, FPGA_MGT.sch]
2020-05-21 Convert "~" and "~~" in .sch and .lib files to " "
    [AMC_FMC_Carrier-PcbDoc.sch, AMC_connector.sch, ETH_PHY.sch, FMC_1.sch, FMC_2.sch, FPGA.sch, FPGA_13_14.sch, FPGA_15_16.sch]
2020-05-21 Sanitize pin counts in schematics
    A lot of them were listed as 2.0000000000000000e+00
    [ETH_PHY.sch, FMC_1.sch, FMC_2.sch, FPGA.sch, FPGA_13_14.sch, FPGA_15_16.sch, FPGA_MGT.sch, FPGA_PWR&MISC.sch]
2020-05-21 Trash HelpURL ComponentLink1URL ComponentLink2URL attributes
    Removes 1056 useless and library-mismatched attributes
    [AMC_FMC_Carrier-PcbDoc.sch, AMC_connector.sch, ETH_PHY.sch, FMC_1.sch, FMC_2.sch, FPGA.sch, FPGA_13_14.sch, FPGA_15_16.sch]
2020-05-21 Trash "Footprint Library" and "Database Table Name" attributes
    Takes 100 attributes out of schematic, 174 out of library
    [AMC_FMC_Carrier-PcbDoc.sch, FMC_1.sch, FMC_2.sch, FPGA_15_16.sch, FPGA_PWR&MISC.sch, I2C_MUX.sch, JTAG.sch, Power.sch]
2020-05-21 Trash SCEM attribute
    [AMC_FMC_Carrier-PcbDoc.sch, ETH_PHY.sch, FMC_1.sch, FMC_2.sch, FPGA_15_16.sch, FPGA_MGT.sch, FPGA_PWR&MISC.sch, JTAG.sch]
2020-05-22 Touch up a few symbols and instances
    Add attribute names to MIC2090
    Fix spelling error in XRP7724 description
    Remove stray AMC_FMC_Carrier-PcbDoc-cache.lib
    [FMC_1.sch, FMC_2.sch, FPGA_15_16.sch, MMC.sch, Power_SW.sch, USB.sch, WhiteRabbit.sch]
2020-05-22 More bizarre touch-up of symbols and instances
    Restore "0" Val field for R189 R196
    Trash CreateDate1 and LatestRevisionDate1
    Name the Val field for MOLEX_87831-1420-MOLEX PB_TYCO_FSM2JSMA-Switches SAMTEC_MHDMR-19-02-H-TH-L-TR-SAMTEC
    [Power_SW.sch]
2020-05-22 Renumber F sequences again
    [AMC_FMC_Carrier-PcbDoc.sch, AMC_connector.sch, ETH_PHY.sch, FMC_1.sch, FMC_2.sch, FPGA.sch, FPGA_13_14.sch, FPGA_15_16.sch]
2020-05-22 fixed rotated LEDs issue, new footprint for J14
    [JTAG.sch]
2020-05-22 Add two mounting holes
    [AMC_FMC_Carrier-PcbDoc.sch]
2020-05-23 Manufacturer Part Number clean-up
    Convert Manufacturer Part Number BAT165AX to BAT165
    The AX suffix refers to Nexperia, and the Manufacturer we list is Infineon.
    Digi-Key has both Nexperia BAT165AX and Infineon BAT165E6327HTSA1 in stock, and the two are fungible to us
    Get rid of stray ,115 after BC857BV in a couple of places
    [JTAG.sch, MMC.sch, Power.sch, Power_SW.sch, USB.sch]
2020-05-23 Remove AMC_FMC_Carrier-PcbDoc-cache.lib
    And modify .gitignore so it's less likely to come back
2020-05-23 Improve listing for SN65MLVD2DRBT
    In both U42 instance, and the library
    [FPGA_15_16.sch]
2020-05-23 More attribute fixes
    Fix up Attribute names in HDT0001 and AG5300
    Remove stray attribute for SN65MLVD2DRBT (added in last commit)
    [AMC_FMC_Carrier-PcbDoc.sch, Power.sch]
2020-05-23 More fussing with attributes
    Library Name, PackageDescription
    Manufacturer1 Example and Manufacturer1 Part Number for CC0805_22UF_16V_10%_X5R
    [SFP1.sch, SFP2.sch, SFP3.sch, SFP4.sch]
2020-05-23 Trigger one less warning from KiBoM
    [FPGA_15_16.sch]
2020-05-24 Swap out 1206 ceramic caps for 0805
    Only the schematic change is in this commit
    [FMC_1.sch, FMC_2.sch, Power_SW.sch]
2020-05-24 Start updating C6 C62 C141 to 0805
    Push C141 to back
    Footprints are still somehow 3216 (metric)
2020-05-24 Fix footprint field in sch. and symbol lib.
    ... concerns U44 - U46, which didn't have the Marble: prefix
    [AMC_FMC_Carrier-PcbDoc.sch, FMC_1.sch, FMC_2.sch, FPGA_15_16.sch]
2020-05-24 LED footprint: change pad number A, C to 2, 1
2020-05-24 Actually change footprints on C6 C62 C141
2020-05-24 Convert 7 x CC0805_22UF_16V_10%_X5R to CC0805_22UF_25V_20%_X5R
    Yageo CC0805MKX5R8BB226, $0.24300 in 100s at Digi-Key
    [FMC_1.sch, FMC_2.sch, Power_SW.sch]
2020-05-25 Convert 3 caps to CC0402_10NF_35V_10%_X7R
    C107 C188 C189
    TDK CGA2B3X7R1V103K050B, $0.03250 in 100s at Digi-Key
    Reduces BOM count by one
    [Thermometers.sch, WhiteRabbit.sch]
2020-05-25 Add attributes including SMD to J14
    [JTAG.sch]
2020-05-25 Upgrade voltage rating on 0402 100nF
    Convert 16 caps from CC0402_100NF_16V_10%_X5R to CC0402_100NF_25V_10%_X5R
    C5 C61 C128 C130 C131 C134 C135 C137 C140 C147 C148 C149 C150 C357 C362 C363
    Samsung CL05A104KA5NNNC, $0.00658 in 500s at Digi-Key
    [FMC_1.sch, FMC_2.sch, Power.sch, Power_SW.sch]
2020-05-25 Upgrade voltage rating on 0603 4.7uF
    Convert 26 caps from CC0603_4.7UF_16V_10%_X5R to CC0603_4.7UF_25V_10%_X5R
    C57 C103 C105 C127 C129 C139 C142 C143 C144 C159 C161 C162 C167 C168 C173 C195 C331 C343 C344 C347 C348 C349 C360 C361 C364 C373
    Samsung CL10A475KA8NQN, $0.11456 in 500s at Digi-Key
    [ETH_PHY.sch, FPGA_15_16.sch, Power.sch, Power_SW.sch, SDRAM.sch, Thermometers.sch, USB.sch]
2020-05-25 Straighen out FMC hole pattern a bit
    One hole was off by 0.6 mm
2020-05-25 Move silkscreen labels for mounting holes
    B10 in particular was misleading
2020-05-25 Increase mounting hole drill size to 2.95mm
    Close-fit clearance for 4-40 screws, so U.S. shops don't have to find and use "special" M2.5 screws
2020-05-26 Add two user LEDs to FPGA pins
    LD16 LD17
    [FPGA_15_16.sch]
2020-05-26 added SI570, U39 3V3 -> 3V3P
    [AMC_FMC_Carrier-PcbDoc.sch, FPGA.sch, FPGA_MGT.sch, SDRAM.sch, WhiteRabbit.sch]
2020-05-26 More work on Si570 circuit
    Attach SI570_{SCL,SDA} to I2C_APP
    Make a part number for Y6 visible on schematic
    Mark Y6 Si570 as dnf
    Mark C385 C386 as dnf
    Layout passes DRC
    [AMC_FMC_Carrier-PcbDoc.sch, FPGA_MGT.sch, WhiteRabbit.sch]
2020-05-26 Silkscreen adjustments around LD16 and LD17
    Move and correct the URL as well
2020-05-26 Move more I2C features to +3V3P
    Move U34 (PCA9555) supply to +3V3P
    Move R45 R46 R47 R48 pullups for FMC I2C to +3V3P
    [FPGA.sch, I2C_MUX.sch]
2020-05-26 Better attribute consistency: fewer warnings from KiBoM
    Someday maybe we'll just nuke the Comment field entirely
    [FPGA_15_16.sch, WhiteRabbit.sch]
2020-05-27 SCH: connect SI570_OE to U39 P0_0 (pin 1)
    ... also rotated 6 net labels to make the
    little _not connected_ square disappear
    [AMC_FMC_Carrier-PcbDoc.sch, FPGA.sch]
2020-05-27 schematic: clean up FPGA_MGT sheet
    * align labels
    * make config field visible
    * add a comment what the new annotation means
    [FPGA.sch, FPGA_MGT.sch]
2020-05-27 PCB: connect SI570_OE to U39 P0_0 (pin 1)
2020-05-27 SCH: add +standalone to 18 capacitors & more notes
    [FPGA_MGT.sch]
2020-05-27 Add pullups to I2C_PM bus
    [MMC.sch]
2020-05-27 Start filling in more Manufacturer fields
    [FPGA_13_14.sch, FPGA_34_35.sch, FPGA_MGT.sch, FPGA_PWR&MISC.sch, I2C_MUX.sch, MMC.sch, Power_SW.sch, SDRAM.sch]
2020-05-27 List more Manufacturers
    [PMOD.sch, Power.sch, Thermometers.sch, WhiteRabbit.sch]
2020-05-27 Fill in Manufacturer for connectors
    [FPGA_13_14.sch, MMC.sch, Power_SW.sch]
2020-05-27 More part number progress
    [FMC_1.sch, FMC_2.sch, Power.sch]
2020-05-28 xy_post.xy: refresh after last change to bom.ini
2020-05-28 A little more clarity on Manufacturer and Part Number
    Adjustments to DDR3 memory, a resistor, and a push-button
    [FPGA_PWR&MISC.sch, Power.sch, SDRAM.sch]
2020-05-28 Change R282 from 4K7 to 5K1
    Reduces BoM line count by one
    [FPGA_13_14.sch, FPGA_PWR&MISC.sch]
2020-05-28 Change 8 x TMDS termination resistors from 49R9 to 51R
    R226 R219 R211 R208 R207 R206 R164 R141
    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
    [FPGA_15_16.sch]
2020-05-28 First attempt at part number mapping
    To test:
    python non_generic.py AMC_FMC_Carrier-PcbDoc_bom_9.csv foo
    Not yet integrated into the flow
2020-05-28 more manufacturing export scripting
    * gerber, drill and position files are now generated by
    kicad_exporter.py
    * updated manufacturing.sh to use it
    * also tested with KiBom master, which works after patching
    its issue #101
2020-05-28 Update I2C documentation
    Closes issue #58
    [I2C_MUX.sch]
2020-05-28 kicad_exporter: only put smd parts in .pos file
2020-05-29 manufacturing.sh: use python3 for kicad_exporter.py
2020-05-29 Fuss with resistor values and configuration
    Change R62 R64 from 0603 4K99 to 0402 5K1
    Convert R221 R222 to 1K (UG470 Table 2-4 specifies <= 1kOhm)
    Mark R142 as DNF, so FPGA_INIT is only pulled up
    [ETH_PHY.sch, FPGA_13_14.sch, I2C_MUX.sch, MMC.sch]
2020-05-29 Mounting holes
    Add B13 near front panel
    Un-ground B9 and B10, AMC features
    [AMC_FMC_Carrier-PcbDoc.sch]
2020-05-29 Start adding isolation for I2C_FPGA_SW_RST and EXP_INT
    Adds U47, another TCA9517
    [AMC_FMC_Carrier-PcbDoc.sch, FPGA.sch, FPGA_15_16.sch, MMC.sch]
2020-05-29 Minor improvements to labels on silkscreen
    Shift LD16 LD17 to make room
2020-05-29 Mark more parts +standalone, like 8P8C and PoE
    J1 J4 J15 U40 C353 C354 Cage1
    Many others are also possible, but would make rework much harder, so don't do that now
    R220 C37 R217 R218 Q20 Q21 D10 D11 R141 R164 R206 R207 R208 R211 R219 R226
    U41 R281 D6 D7 D8 L35 L36 L37 L38 L39 L40 C350 D12
    [ETH_PHY.sch, FPGA_15_16.sch, Power.sch, SFP1.sch]
2020-05-29 Squelch a stupid warning from KiBoM
    [FPGA_15_16.sch]
2020-05-30 sch: connect FPGA_DONE to U46, U47
    also clean up some overlapping elements
    and miss-aligned labels
    [FPGA.sch, FPGA_15_16.sch, MMC.sch]
2020-05-30 Modify silkscreen
    Mostly adjust size and weight of lettering
    Also remove two stray polygons
2020-05-30 Adjust mounting hole positions slightly
    Puts them all on 0.1 mm grid, defined by FMC holes
    One trace is slightly rerouted to maintain DRC
2020-05-31 Part substitutions
    Mercury VM53S3-25.000-2.5/-30+75 (Y2) => Taiten TXEAADSANF-25.000000 (Y1)
    IQD LFVCXO026156 => Kyocera KV7050B20.0000C3GD00
    Kingbright KPH-1608CGCK => Wurth 150060VS75000
    Should make it easier to source parts in the USA in 2020
    Also remove un-helpful (DC-10A) from Cliff FC68148;
    Manufacturer part numbers now no longer have spaces; can't say the same about Manufacturer
    [FPGA_15_16.sch, FPGA_PWR&MISC.sch, MMC.sch, Power.sch, Power_SW.sch, WhiteRabbit.sch]
2020-05-31 Fix up a couple BOM entries
    Fix two typos in generic_subst
    Change from Samtec to Amphenol for HDMI connector (Digi-Key has the Amphenol part, but not the one from Samtec)
    [FPGA_15_16.sch]
2020-06-01 kicad_exporter.py: very small adjustments
    One less warning from flake8
    Include trailing ## End line in the pos file output
2020-06-02 kicad_exporter.py: match pcbnew whitespace
2020-06-02 change silkscreen logo to `Marble-Mini v1.0.1`
    also add the inkscape .xml source file
    for reference: font = roboto, style = bold, size = 14
2020-06-02 update logo on bottom silkscreen as well
2020-06-02 More silkscreen adjustments
    Increase font weights a bit
    De-overlap Q2 label with KiCad logo on back
2020-06-02 update QR code footprint, not yet placed on PCB
2020-06-02 More silkscreen refinements
    Mostly move silk off of pads
    Add six 8mm circles on bottom to guide rubber foot placement
    Increase size of J1 refdes
2020-06-02 Fix spelling of Taitien
    Manufacturer of VCTCXO
    [WhiteRabbit.sch]
2020-06-03 add TE 641119-2 footprint / symbol
2020-06-03 First try adding MTA-156-2 power input port
    J17, marked dnf, but easy to add by hand
    [Power.sch]
2020-06-03 Correct and refine use of MTA-156 for power input
    Use pin 1 and polarity convention that matches previous LBNL usage.
    Unfortunately not consistent with TEConn convention for pin 1.
    [Power.sch]
2020-06-03 Move explanation of ERC error status from README.md to WhiteRabbit.sch
    Old description was obsolete anyway.
    [WhiteRabbit.sch]
2020-06-03 Label +12V and GND on J17
2020-06-22 Apply constructive changes from Michal's "better pinout for fan connctors"
    But don't nuke artwork on the silkscreen.
    Discards commits c7a1dc17, ed39472a, 839001d1 from fab2 branch.
    Those changes are still accessible via michal_fan branch.
2020-06-23 Move RTS_OUT and DTR_OUT from U23 (FT4232) bank D to bank B
    Will let people reliably connect a USB UART to the MMC without accidentally resetting it.
    Sorry the _pcb diff is so big; KiCad managed to renumber the nets.
    [USB.sch]
2020-06-23 Slight adjustment of some silkscreen labels
    Grid ID for FMC connectors
2020-06-24 Increase FTDI EEPROM size to 128x16
    Microchip 93LC56B-I/SN replaces STMicro M93C46-WMN6TP.
    No change to copper.
    [USB.sch]
2020-06-25 Remove a couple stray files
    Include *.bck in .gitignore
    Remove one more temp file at end of scripts/manufacturing.sh run
2020-08-05 README.md: add notes on powering the board
2020-08-20 Change all schematic title blocks from Marble to Marble-Mini
    [AMC_FMC_Carrier-PcbDoc.sch, AMC_connector.sch, ETH_PHY.sch, FMC_1.sch, FMC_2.sch, FPGA.sch, FPGA_13_14.sch, FPGA_15_16.sch]
2020-08-20 Apply lessons learned about getting CDCM61004 to start reliably
    Based on experiments using Taitien VCTCXO
    Change out R95 dnf to C389 100nF 0402 (see instructions in TI SCAA111)
    Change C114 from 100nF 0201 to 2.2nF 0402
    Only the former change has been hardware-tested
    [WhiteRabbit.sch]
2020-08-20 Add new R95 series damping resistor for CLK_25MHZ line
    May or may not be needed; worst case the 40.2 Ohm can be replaced with 0 Ohm
    [WhiteRabbit.sch]
2020-08-20 WhiteRabbit.sch: more consistent metadata on recently modified components
    Keeps KiBoM quieter
    [WhiteRabbit.sch]
2020-08-22 Put a big bright "Marble-Mini" on schematic front page
    [AMC_FMC_Carrier-PcbDoc.sch]
2020-09-12 Use same value for all four SFP instances
    TYCO_1888247-1
    [SFP2.sch]
2020-09-14 Fill in SMD field of all components
    Accomplished using eeschem "Edit Symbol Fields"
    Makes for a nicer BOM spreadsheet export
    Creates mismatch to corresponding library components
    Cross-checked results with xy_post.py
    [AMC_FMC_Carrier-PcbDoc.sch, ETH_PHY.sch, FMC_1.sch, FMC_2.sch, FPGA_13_14.sch, FPGA_15_16.sch, FPGA_34_35.sch, FPGA_MGT.sch]
2020-09-15 Move pin-1 marker for J9
    To a position where it can't be interpreted as a pin-1 marker for U35
2020-09-24 update silkscreen and qr-codes with v1.1
    * update qr-codes and qr_create.py with new url:
    https://github.com/BerkeleyLab/Marble-Mini/releases/tag/v1.1
    * change schematic revision field to v1.1
    * change text under Marble-Mini logo from v1.0.1 to v1.1
    * should be ready to merge into master and release
    [AMC_FMC_Carrier-PcbDoc.sch, AMC_connector.sch, ETH_PHY.sch, FMC_1.sch, FMC_2.sch, FPGA.sch, FPGA_13_14.sch, FPGA_15_16.sch]
2020-09-25 update schematic rev field to `v1.1`
    [AMC_FMC_Carrier-PcbDoc.sch, AMC_connector.sch, ETH_PHY.sch, FMC_1.sch, FMC_2.sch, FPGA.sch, FPGA_13_14.sch, FPGA_15_16.sch]
2020-09-29 Realign auto-generated netlist with copy in bedrock
    Names two new nets on schematic
    Reduces diffs between netlist_to_xdc.py and copy in Marble repo
    [FPGA_15_16.sch]
2020-09-30 Label LD16 and LD17 nets
    ... so they come out in the xdc file
    [FPGA_15_16.sch]
2021-11-09 Update README.md
    https://forum.kicad.info/t/warning-avoid-all-links-to-kicad-pcb-org-use-kicad-org/31521
