BerkeleyLab/Marble-Mini/(notices)

Notices in the files:
parts and their libraries:
This work is licensed under the Creative Commons CC-BY-SA 4.0 License. To the extent that circuit schematics that use Licensed Material can be considered to be ‘Adapted Material’, then the copyright holder waives article 3.b of the license with respect to these schematics.
